ashleyjr/Switcher/README.md

# Switcher

Hackaday 1KB challenge

https://hackaday.io/project/18649-switcher

Switch mode power supply controlled by an 8051 microcontroller.
