ashleyjr/Switcher/Documentation/Switcher.pdf

# Switcher

# Ashley J. Robinson

# January 3, 2017

# 1 Introduction

# 2 Hardware

# 3 Software

# 3.1 Peripherals

# 3.1.1 Analogue to Digital Convertors (ADCs)

A single ADC is multiplexed to measure three voltages on the board.

# 3.1.2 Universal Asyncronhouse/Syncronhous Transceiver (UART)

The UART is configure to run at 115200 baud with no control flow with a ring buffer interface.

# Trasmission from the microcontroller happens through uartLoadOut which adds to the 8 byte buffer and is then unloaded from a timer. The input is not interrupt driven and is

handled in the main control loop using a 5 byte buffer that is enough to contain the longest command.

# 3.1.3 Programmable Counter Array (PCA)

# The Pulse Width Modulation (PWM) is controlled from the counter array. The output runs

at approximatly 96KHz with 8 bits to control the duty cycle. A high resolution for control would be favourable for this application but the frequency achieved in 16-bit mode is far too low for this application.

# 3.1.4 Timers

# Timer 0 is used as baud rate generagtion for the UART. Timer 2 is used to trigger an In-

terrupt Service Routine (ISR) which runs at 4KHz. The ISR control the UART transmission, sampling of the ADC, running the controller and finally setting the PWM.

# 3.2 Operation

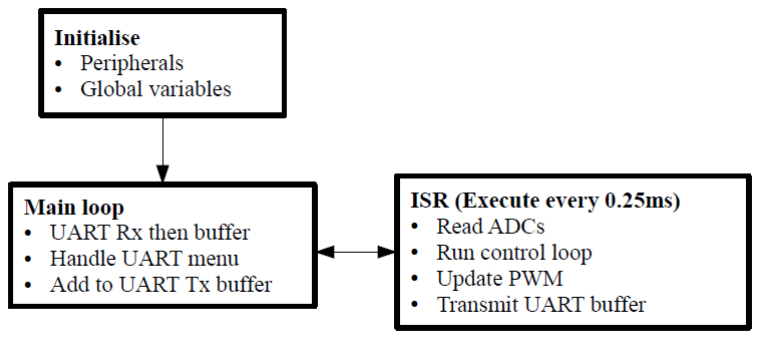
[picture p8: figure]

Figure 1: Software overview.

# 3.3 UART Menu

Command | Char | Send numbers | Return numbers | Notes
Enable | g | 0 | 0 | 0
Disable | s | 0 | 0 | 0
Read ADC1 | x | 0 | 4 | Result in mV
Read ADC2 | y | 0 | 4 | Result in mV
Read ADC3 | z | 0 | 4 | Result in mV
Read output current | j | 0 | 4 | Result in mA
Set output voltage | v | 4 | 0 | Send value in mV
Set otuput current | c | 4 | 0 | Send value in mA
Set controller P | p | 4 | 0 | Value is divide by 10
Set controller I | i | 4 | 0 | Value is divide by 10
Set input voltage up-per limit | u | 4 | 0 | Send value in mV
Set input voltage lower limit | l | 4 | 0 | Send value in mV

# Table 1: UART menu

# 3.4 Assembly analysis

The following sections of code are library function inserted by the compilier implict to facilite some more complex operations.

# 3.4.1 ADC scaling

Listing 1 is a line of code operating on a 32 bit signed integer and invokes listing 5 and 6. The purpose of this operation is to cast the voltage recorded by the ADC to a representation in mV. It is possible for the target voltage to be translated instead but this would still require

# the same piece of code. The 12 bit oputput but the ADC must be multiplied 5.926 as to

represent the voltage at the top of the potential divider. Fixed but multiplication followed by a shift operation removes the need for a floating point operation but yeilds the same result.

# Listing 1: LIMUL

return ((( U32 ) ADC0 )* SCALE_MUL ) >> 10;

# 3.4.2 ADC scaling

# 3.4.3 Division

Division and modulus operations are contained in 2 invoke the functions contained in 8.

# Listing 2: Division

scale /= 10;

num = out / scale ;

out %= scale ;

# 3.4.4 Switch

# This library function is generated to control large switch statements??

# 4 Testing

# The potential dividers constantly place the power supply under a load of 515Ω. To test both the UART interface anhd the switch mode functionaility a small python script is used to create GUI to plot values in real time. The input and output voltages recorded by the

mircocontroller are contained in Figure 2 and the actual values are contained in 3.


Figure 2: Sine wave output on GUI.


Figure 3: Sine wave output on scope.

# 5 Conclusion

# The complete assembly in listing 4 is generated from the code in listing 3. The C code is

contained within a single file and generates 950 lines of assembler with an additional 3 lines contained within the jump table and the jump on reset...

# - 0x0000 Jumps straight to 0x0800

# - 0x001B Jump table entry TIMER1 ISR(C:0BB6)

# - 0x002B Jump table entry TIMER2 ISR(C:094C)

# - 0x0800 First line of code generated from main.c

# - 0x0BB6 Final line of code generated from main.c

# The Keil c51 compilier limits machine code generation to 2KB (not a problem) however it also limits the use of memory less than 2KB by always jumping to address 2048 and

then continuing with the compiled assembler. Excluding the first 2048 is not completely fair because the jump on reset and the jump table would still exsist. The highest vector used in the jump table is at address 43 so assuming this is not optimised by the compilier the total code size comes to 993 bytes.

# 5.1 Further work

# - Improve output current

# - Replaced protection diodes with sutiable parts

# - Improve resolution of ADC to enable constant control

# 6 Appendix

# 6.1 Code listings

# Listing 3: main.c

// - - - - - - - - - - - - - - - - - - - - - - - - - - - - - - - - - - - - - - - - - - - - - - - - - - - - - - - - - - - - - - - - - - - - - - - - - - - - -// Project : Switcher
// File : | main . c
// Brief : | Single main file containing all code
// - - - - - - - - - - - - - - - - - - - - - - - - - - - - - - - - - - - - - - - - - - - - - - - - - - - - - - - - - - - - - - - - - - - - - - - - - - - - -

// - - - - - - - - - - - - - - - - - - - - - - - - - - - - - - - - - - - - - - - - - - - - - - - - - - - - - - - - - - - - - - - - - - - - - - - - - - - - -// Includes
// - - - - - - - - - - - - - - - - - - - - - - - - - - - - - - - - - - - - - - - - - - - - - - - - - - - - - - - - - - - - - - - - - - - - - - - - - - - - -

# include " SI_C8051F850_Register_Enums .h "

# include " SI_C8051F850_Defs .h"

// - - - - - - - - - - - - - - - - - - - - - - - - - - - - - - - - - - - - - - - - - - - - - - - - - - - - - - - - - - - - - - - - - - - - - - - - - - - - -// Defines
// - - - - - - - - - - - - - - - - - - - - - - - - - - - - - - - - - - - - - - - - - - - - - - - - - - - - - - - - - - - - - - - - - - - - - - - - - - - - -
# define SYSCLK | 24500000 | // SYSCLK frequency in Hz

# define BAUDRATE | 115200 | // Baud rate of UART in bps

# define P | 5

# define I | 2

# define UART_SIZE_IN | 5

# define UART_SIZE_OUT | 8

# define ADC1 | 0 x08

# define ADC2 | 0 x09

# define ADC3 | 0 x0A

# define SCALE_MUL | 6068 | // When combined with >> 10 will scale by 5.926 to compensate for potential divider

# define DEFAULT_OUT_MV | 5000

# define DEFAULT_HIGH_MV | 6000

# define DEFAULT_LOW_MV | 4000

SBIT ( TEST2 , SFR_P1 , 3); | // DS5 P1 .0 LED
SBIT ( TEST1 , SFR_P1 , 4); | // DS5 P1 .0 LED

// - - - - - - - - - - - - - - - - - - - - - - - - - - - - - - - - - - - - - - - - - - - - - - - - - - - - - - - - - - - - - - - - - - - - - - - - - - - - -// Prototypes
// - - - - - - - - - - - - - - - - - - - - - - - - - - - - - - - - - - - - - - - - - - - - - - - - - - - - - - - - - - - - - - - - - - - - - - - - - - - - -

U16 readAdc ( U8 sel );
void uartLoadOut ( U8 tx );
U16 uartNumbers ( U16 toSend , bool transmit );

// - - - - - - - - - - - - - - - - - - - - - - - - - - - - - - - - - - - - - - - - - - - - - - - - - - - - - - - - - - - - - - - - - - - - - - - - - - - - -// Global Variables
// - - - - - - - - - - - - - - - - - - - - - - - - - - - - - - - - - - - - - - - - - - - - - - - - - - - - - - - - - - - - - - - - - - - - - - - - - - - - -
volatile U8 | uart_in [ UART_SIZE_IN ];
volatile U8 | uart_out [ UART_SIZE_OUT ];
volatile U8 | head ;
volatile U8 | tail ;
volatile int | integral ;
volatile U8 | duty ;
volatile U16 | high_mV ;
volatile U16 | low_mV ;
volatile U16 | target_mV ;
volatile bool | enabled ;
volatile U16 | adc1 ;
volatile U16 | adc2 ;
volatile U16 | adc3 ;
volatile U16 | current ;

// - - - - - - - - - - - - - - - - - - - - - - - - - - - - - - - - - - - - - - - - - - - - - - - - - - - - - - - - - - - - - - - - - - - - - - - - - - - - -// Main Routine
// - - - - - - - - - - - - - - - - - - - - - - - - - - - - - - - - - - - - - - - - - - - - - - - - - - - - - - - - - - - - - - - - - - - - - - - - - - - - -

void main ( void ){
// Start of peripheral setup
U8 TCON_save ;
// Watchdog
WDTCN = 0 xDE ; | // First key
WDTCN = 0 xAD ; | // Second key - Watchdog now disabled
// Clock
CLKSEL =
CLKSEL_CLKSL__HFOSC | | | // Use 24.5 MHz interal clock
CLKSEL_CLKDIV__SYSCLK_DIV_1 ; | // Do not divide
// Port 0
P0MDOUT =
P0MDOUT_B0__PUSH_PULL | | | // PWM1 output
P0MDOUT_B1__PUSH_PULL | | | // PWM2 output
P0MDOUT_B2__OPEN_DRAIN | |
P0MDOUT_B3__OPEN_DRAIN | |
P0MDOUT_B4__PUSH_PULL | | | // UART TX
P0MDOUT_B5__OPEN_DRAIN | | | // UART RX
P0MDOUT_B6__OPEN_DRAIN | |

P0MDOUT_B7__OPEN_DRAIN ;
// Port 1
P1MDOUT =
P1MDOUT_B0__OPEN_DRAIN | |
P1MDOUT_B1__OPEN_DRAIN | |
P1MDOUT_B2__OPEN_DRAIN | |
P1MDOUT_B3__PUSH_PULL | | | // TEST2
P1MDOUT_B4__PUSH_PULL | | | // TEST1
P1MDOUT_B5__OPEN_DRAIN | |
P1MDOUT_B6__OPEN_DRAIN | |
P1MDOUT_B7__OPEN_DRAIN ;
P1MDIN =
P1MDIN_B0__ANALOG | | | // ADC1
P1MDIN_B1__ANALOG | | | // ADC2
P1MDIN_B2__ANALOG | | | // ADC3
P1MDIN_B3__DIGITAL | |
P1MDIN_B4__DIGITAL | |
P1MDIN_B5__DIGITAL | |
P1MDIN_B6__DIGITAL | |
P1MDIN_B7__DIGITAL ;
// Port crossbar
XBR0 =
XBR0_URT0E__ENABLED | | | // Route out UART
XBR0_SPI0E__DISABLED | |
XBR0_SMB0E__DISABLED | |
XBR0_CP0E__DISABLED | |
XBR0_CP0AE__DISABLED | |
XBR0_CP1E__DISABLED | |
XBR0_CP1AE__DISABLED | |
XBR0_SYSCKE__DISABLED ;
XBR1 =
XBR1_PCA0ME__CEX0_CEX1 | | | // Route out PCA0 and PCA1
XBR1_ECIE__DISABLED | |
XBR1_T0E__DISABLED | |
XBR1_T1E__DISABLED | |
XBR1_T2E__DISABLED ;
XBR2 =
XBR2_WEAKPUD__PULL_UPS_ENABLED | | | // Weak pull ups
XBR2_XBARE__ENABLED ; | | // Enable cross bar
// ADC
// ADC0MX = | | // Mux set in application
// | A D C 0 M X _ A D C 0 M X _ _ A D C 0 P 1 0 ;
ADC0CF =
(1 << ADC0CF_ADSC__SHIFT ) | |
ADC0CF_AD8BE__NORMAL | | | // ADC set to 10 bit
ADC0CF_ADGN__GAIN_1 | | | // ADC gain set to 1
ADC0CF_ADTM__TRACK_NORMAL ; | | // Immediate covert
ADC0CN0 &=
~ ADC0CN0_ADCM__FMASK ;
ADC0CN0 |=
ADC0CN0_ADEN__ENABLED | |
ADC0CN0_ADCM__ADBUSY ;
// Timer 0
TCON_save = TCON ;
TCON &=
TCON_TR0__BMASK | &
TCON_TR1__BMASK ;
TH1 = (150 << TH1_TH1__SHIFT );
TL1 = (150 << TL1_TL1__SHIFT );
TCON =
TCON_save ;
// Timer setup
CKCON =
CKCON_SCA__SYSCLK_DIV_12 | |
CKCON_T0M__PRESCALE | |
CKCON_T3MH__EXTERNAL_CLOCK | |
CKCON_T3ML__EXTERNAL_CLOCK | |
CKCON_T1M__SYSCLK ;
TMOD =
TMOD_T0M__MODE0 | |
TMOD_CT0__TIMER | |
TMOD_GATE0__DISABLED | |
TMOD_T1M__MODE2 | |
TMOD_CT1__TIMER | |
TMOD_GATE1__DISABLED ;
TCON |=
TCON_TR1__RUN ;
// UART
SCON0 |=
SCON0_REN__RECEIVE_ENABLED ;
// VREF
REF0CN =
REF0CN_REFSL__VDD_PIN | |
REF0CN_IREFLVL__1P65 | |
REF0CN_GNDSL__GND_PIN | |
REF0CN_TEMPE__TEMP_DISABLED ;
// RSTSRC
RSTSRC =
RSTSRC_C0RSEF__NOT_SET | |
RSTSRC_MCDRSF__SET | |
RSTSRC_PORSF__SET | |
RSTSRC_SWRSF__NOT_SET ;
// Interrupt
IE =
IE_EA__ENABLED | |
IE_EX0__DISABLED | |
IE_EX1__DISABLED | |
IE_ESPI0__DISABLED | |
IE_ET0__DISABLED | |

IE_ET1__ENABLED | | | // Timer 1 enabled
IE_ET2__ENABLED | | | // Timer 2 enabled
IE_ES0__ENABLED ;
IP =
IP_PX0__LOW | |
IP_PX1__LOW | |
IP_PSPI0__LOW | |
IP_PT0__LOW | |
IP_PT1__LOW | |
IP_PT2__HIGH | | | // Timer 2 highest priority
IP_PS0__LOW ;
// PCA
PCA0CN_CR =
PCA0CN_CR__STOP ;
PCA0CPM0 =
PCA0CPM0_CAPN__DISABLED | |
PCA0CPM0_ECCF__ENABLED | |
PCA0CPM0_MAT__ENABLED | |
PCA0CPM0_CAPP__DISABLED | |
PCA0CPM0_ECOM__ENABLED | |
PCA0CPM0_PWM__ENABLED | |
PCA0CPM0_TOG__DISABLED ;
PCA0CPM1 =
PCA0CPM1_CAPN__DISABLED | |
PCA0CPM1_ECCF__ENABLED | |
PCA0CPM1_MAT__ENABLED | |
PCA0CPM1_CAPP__DISABLED | |
PCA0CPM1_ECOM__ENABLED | |
PCA0CPM1_PWM__ENABLED | |
PCA0CPM1_TOG__DISABLED ;
PCA0MD =
PCA0MD_CIDL__NORMAL | |
PCA0MD_ECF__OVF_INT_DISABLED | |
PCA0MD_CPS__SYSCLK ;
PCA0CN |=
PCA0CN_CR__RUN ;
// Timer 2
TMR2CN |= TMR2CN_TR2__RUN ; // End of peripheral setup
enabled | = false ;
integral | = 0;
target_mV | = DEFAULT_OUT_MV ;
high_mV | = DEFAULT_HIGH_MV ;
low_mV | = DEFAULT_LOW_MV ;
SCON0_TI | = 1;
SCON0_RI | = 0;

while (1){
if ( SCON0_RI ){
SCON0_RI = 0;
uart_in [4] = uart_in [3]; | // Small buffer , less code not to use loop
uart_in [3] = uart_in [2];
uart_in [2] = uart_in [1];
uart_in [1] = uart_in [0];
uart_in [0] = SBUF0 ;

uartLoadOut ( uart_in [0]);

switch ( uart_in [0]){
case ’a ’: uartNumbers ( target_mV , true ); break ;
case ’c ’: uartNumbers ( current , true ); break ;
case ’d ’: uartNumbers ( duty , true ); break ;
case ’g ’: | enabled | = true ;
integral | = 0;
break ;
case ’s ’: | enabled | = false ;
break ;
case ’m ’: uartNumbers ( high_mV , true ); break ;
case ’n ’: uartNumbers ( low_mV , true ); break ;
case ’x ’: uartNumbers ( adc1 , true ); break ;
case ’y ’: uartNumbers ( adc2 , true ); break ;
case ’z ’: uartNumbers ( adc3 , true ); break ;
default : | switch ( uart_in [4]){
case ’h ’: | high_mV | = uartNumbers ( high_mV , false );
break ;
case ’l ’: | low_mV | = uartNumbers ( low_mV , false );
break ;
case ’v ’: | target_mV | = uartNumbers ( target_mV , false );
integral | = 0;
break ;
}
break ;
}
}
}
}

// - - - - - - - - - - - - - - - - - - - - - - - - - - - - - - - - - - - - - - - - - - - - - - - - - - - - - - - - - - - - - - - - - - - - - - - - - - - - -// Routines

// - - - - - - - - - - - - - - - - - - - - - - - - - - - - - - - - - - - - - - - - - - - - - - - - - - - - - - - - - - - - - - - - - - - - - - - - - - - - -

void uartLoadOut ( U8 tx ){ | // Handle buffering out Tx UART
uart_out [ head ] = tx ; | // Buffer outgoing
head ++;
head %= UART_SIZE_OUT ; | // Wrap around
}
U16 uartNumbers ( U16 toSend , bool transmit ){ | // Tx / Rx up to 4 length numbers over UART
U16 out = toSend ;
U16 num = 0;
U16 scale = 10000;
U8 test ;
U8 i = 4;
bool bad = false ;
while (i ){ | // On zero done
scale /= 10; | // Shift
i - -; | // Move through UART array
test = uart_in [i] - 48; | // ascii to num
if ( test > 10){ | // check is 0 to 9 , unsigned
bad = true ;
}
num += test * scale ; | // shift in to position
if ( transmit ){ | // Put if statement at back of loop to save on jumps
num = out / scale ; | // 10 powers
uartLoadOut ( num + 48); | // Number to ascii
out %= scale ; | // Remainder for next time
}
}
uartLoadOut ( ’\ n ’);
uartLoadOut ( ’\ r ’);
if ( bad ){
num = DEFAULT_OUT_MV ; | // Not all valid numbers so set output as default
}
return num ;
}
U16 readAdc ( U8 sel ){ | // Read the available ADCs
U8 i;
ADC0MX = sel ;
for (i =0; i <2; i ++){
ADC0CN0 |= ADC0CN0_ADBUSY__SET ;
while ( ADC0CN0 & ADC0CN0_ADBUSY__SET ); | // Wait for sample to complete
}
return ((( U32 ) ADC0 )* SCALE_MUL ) >> 10; | // Scale to mV
}

// - - - - - - - - - - - - - - - - - - - - - - - - - - - - - - - - - - - - - - - - - - - - - - - - - - - - - - - - - - - - - - - - - - - - - - - - - - - - -// Interrupt Routines
// - - - - - - - - - - - - - - - - - - - - - - - - - - - - - - - - - - - - - - - - - - - - - - - - - - - - - - - - - - - - - - - - - - - - - - - - - - - - -
INTERRUPT ( TIMER1_ISR , TIMER1_IRQn ){} | // Needed for UART timing
INTERRUPT ( TIMER2_ISR , TIMER2_IRQn ){ | // One timer handling UART Tx and PID
int out ;
int error ;
TEST1 = 1;

adc1 = readAdc ( ADC1 );
adc2 = readAdc ( ADC2 );
adc3 = readAdc ( ADC3 );
current = ( adc2 - adc3 )*10;
if (( adc1 < low_mV ) || ( adc1 > high_mV )){ | // Watch input voltage
enabled = false ;
}
error = ( int ) target_mV - ( int ) adc3 ; | // PID controller
integral += error ;
out = (( error *P) + ( integral *I )) >> 10; | // Divide by 1024
if (( out < 0) || (! enabled )){
out = 0;
}
duty = out ;
PCA0CPH0 = PCA0CPH1 = 0 xFF - out ;

if ( head != tail ){
SBUF0 = uart_out [ tail ]; | // Timer tuned so no need to check
tail ++; | // Transmit UART
tail %= UART_SIZE_OUT ; | // Wrap around
}
TMR2H = 255; | // Runs at 4 KHz
TMR2CN_TF2H = 0; | // Enable interrupt again
TEST1 = 0; | // Timing debug
}

// - - - - - - - - - - - - - - - - - - - - - - - - - - - - - - - - - - - - - - - - - - - - - - - - - - - - - - - - - - - - - - - - - - - - - - - - - - - - -// END
// - - - - - - - - - - - - - - - - - - - - - - - - - - - - - - - - - - - - - - - - - - - - - - - - - - - - - - - - - - - - - - - - - - - - - - - - - - - - -

# Listing 4: Swicther.asm

C :0 x0000 | 020 BAA | LJMP | C :0 BAA
C :0 x0003 | 00 | NOP
C :0 x0004 | 00 | NOP
C :0 x0005 | 00 | NOP
C :0 x0006 | 00 | NOP
C :0 x0007 | 00 | NOP
C :0 x0008 | 00 | NOP
C :0 x0009 | 00 | NOP
C :0 x000A | 00 | NOP
C :0 x000B | 00 | NOP
C :0 x000C | 00 | NOP
C :0 x000D | 00 | NOP
C :0 x000E | 00 | NOP
C :0 x000F | 00 | NOP
C :0 x0010 | 00 | NOP
C :0 x0011 | 00 | NOP
C :0 x0012 | 00 | NOP
C :0 x0013 | 00 | NOP
C :0 x0014 | 00 | NOP
C :0 x0015 | 00 | NOP
C :0 x0016 | 00 | NOP
C :0 x0017 | 00 | NOP
C :0 x0018 | 00 | NOP
C :0 x0019 | 00 | NOP
C :0 x001A | 00 | NOP
C :0 x001B | 020 BB6 | LJMP | TIMER1_ISR (C :0 BB6 )
C :0 x001E | 00 | NOP
C :0 x001F | 00 | NOP
C :0 x0020 | 00 | NOP
C :0 x0021 | 00 | NOP
C :0 x0022 | 00 | NOP
C :0 x0023 | 00 | NOP
C :0 x0024 | 00 | NOP
C :0 x0025 | 00 | NOP
C :0 x0026 | 00 | NOP
C :0 x0027 | 00 | NOP
C :0 x0028 | 00 | NOP
C :0 x0029 | 00 | NOP
C :0 x002A | 00 | NOP
C :0 x002B | 02094 C | LJMP | TIMER2_ISR (C :094 C )
C :0 x002E | 00 | NOP
C :0 x002F | 00 | NOP
C :0 x0030 | 00 | NOP
C :0 x0031 | 00 | NOP
C :0 x0032 | 00 | NOP
C :0 x0033 | 00 | NOP
C :0 x0034 | 00 | NOP
C :0 x0035 | 00 | NOP
C :0 x0036 | 00 | NOP
C :0 x0037 | 00 | NOP
C :0 x0038 | 00 | NOP
C :0 x0039 | 00 | NOP
C :0 x003A | 00 | NOP
C :0 x003B | 00 | NOP
C :0 x003C | 00 | NOP
C :0 x003D | 00 | NOP
C :0 x003E | 00 | NOP
C :0 x003F | 00 | NOP
C :0 x0040 | 00 | NOP
C :0 x0041 | 00 | NOP
C :0 x0042 | 00 | NOP
C :0 x0043 | 00 | NOP
C :0 x0044 | 00 | NOP
C :0 x0045 | 00 | NOP
C :0 x0046 | 00 | NOP
C :0 x0047 | 00 | NOP
C :0 x0048 | 00 | NOP
C :0 x0049 | 00 | NOP
C :0 x004A | 00 | NOP
C :0 x004B | 00 | NOP
C :0 x004C | 00 | NOP
C :0 x004D | 00 | NOP
C :0 x004E | 00 | NOP
C :0 x004F | 00 | NOP
C :0 x0050 | 00 | NOP
C :0 x0051 | 00 | NOP
C :0 x0052 | 00 | NOP
C :0 x0053 | 00 | NOP
C :0 x0054 | 00 | NOP
C :0 x0055 | 00 | NOP
C :0 x0056 | 00 | NOP
C :0 x0057 | 00 | NOP
C :0 x0058 | 00 | NOP
C :0 x0059 | 00 | NOP
C :0 x005A | 00 | NOP
C :0 x005B | 00 | NOP
C :0 x005C | 00 | NOP
C :0 x005D | 00 | NOP
C :0 x005E | 00 | NOP
C :0 x005F | 00 | NOP
C :0 x0060 | 00 | NOP
C :0 x0061 | 00 | NOP
C :0 x0062 | 00 | NOP
C :0 x0063 | 00 | NOP
C :0 x0064 | 00 | NOP
C :0 x0065 | 00 | NOP
C :0 x0066 | 00 | NOP
C :0 x0067 | 00 | NOP

C :0 x0068 | 00 | NOP
C :0 x0069 | 00 | NOP
C :0 x006A | 00 | NOP
C :0 x006B | 00 | NOP
C :0 x006C | 00 | NOP
C :0 x006D | 00 | NOP
C :0 x006E | 00 | NOP
C :0 x006F | 00 | NOP
C :0 x0070 | 00 | NOP
C :0 x0071 | 00 | NOP
C :0 x0072 | 00 | NOP
C :0 x0073 | 00 | NOP
C :0 x0074 | 00 | NOP
C :0 x0075 | 00 | NOP
C :0 x0076 | 00 | NOP
C :0 x0077 | 00 | NOP
C :0 x0078 | 00 | NOP
C :0 x0079 | 00 | NOP
C :0 x007A | 00 | NOP
C :0 x007B | 00 | NOP
C :0 x007C | 00 | NOP
C :0 x007D | 00 | NOP
C :0 x007E | 00 | NOP
C :0 x007F | 00 | NOP
C :0 x0080 | 00 | NOP
C :0 x0081 | 00 | NOP
C :0 x0082 | 00 | NOP
C :0 x0083 | 00 | NOP
C :0 x0084 | 00 | NOP
C :0 x0085 | 00 | NOP
C :0 x0086 | 00 | NOP
C :0 x0087 | 00 | NOP
C :0 x0088 | 00 | NOP
C :0 x0089 | 00 | NOP
C :0 x008A | 00 | NOP
C :0 x008B | 00 | NOP
C :0 x008C | 00 | NOP
C :0 x008D | 00 | NOP
C :0 x008E | 00 | NOP
C :0 x008F | 00 | NOP
C :0 x0090 | 00 | NOP
C :0 x0091 | 00 | NOP
C :0 x0092 | 00 | NOP
C :0 x0093 | 00 | NOP
C :0 x0094 | 00 | NOP
C :0 x0095 | 00 | NOP
C :0 x0096 | 00 | NOP
C :0 x0097 | 00 | NOP
C :0 x0098 | 00 | NOP
C :0 x0099 | 00 | NOP
C :0 x009A | 00 | NOP
C :0 x009B | 00 | NOP
C :0 x009C | 00 | NOP
C :0 x009D | 00 | NOP
C :0 x009E | 00 | NOP
C :0 x009F | 00 | NOP
C :0 x00A0 | 00 | NOP
C :0 x00A1 | 00 | NOP
C :0 x00A2 | 00 | NOP
C :0 x00A3 | 00 | NOP
C :0 x00A4 | 00 | NOP
C :0 x00A5 | 00 | NOP
C :0 x00A6 | 00 | NOP
C :0 x00A7 | 00 | NOP
C :0 x00A8 | 00 | NOP
C :0 x00A9 | 00 | NOP
C :0 x00AA | 00 | NOP
C :0 x00AB | 00 | NOP
C :0 x00AC | 00 | NOP
C :0 x00AD | 00 | NOP
C :0 x00AE | 00 | NOP
C :0 x00AF | 00 | NOP
C :0 x00B0 | 00 | NOP
C :0 x00B1 | 00 | NOP
C :0 x00B2 | 00 | NOP
C :0 x00B3 | 00 | NOP
C :0 x00B4 | 00 | NOP
C :0 x00B5 | 00 | NOP
C :0 x00B6 | 00 | NOP
C :0 x00B7 | 00 | NOP
C :0 x00B8 | 00 | NOP
C :0 x00B9 | 00 | NOP
C :0 x00BA | 00 | NOP
C :0 x00BB | 00 | NOP
C :0 x00BC | 00 | NOP
C :0 x00BD | 00 | NOP
C :0 x00BE | 00 | NOP
C :0 x00BF | 00 | NOP
C :0 x00C0 | 00 | NOP
C :0 x00C1 | 00 | NOP
C :0 x00C2 | 00 | NOP
C :0 x00C3 | 00 | NOP
C :0 x00C4 | 00 | NOP
C :0 x00C5 | 00 | NOP
C :0 x00C6 | 00 | NOP
C :0 x00C7 | 00 | NOP
C :0 x00C8 | 00 | NOP
C :0 x00C9 | 00 | NOP
C :0 x00CA | 00 | NOP

C :0 x00CB | 00 | NOP
C :0 x00CC | 00 | NOP
C :0 x00CD | 00 | NOP
C :0 x00CE | 00 | NOP
C :0 x00CF | 00 | NOP
C :0 x00D0 | 00 | NOP
C :0 x00D1 | 00 | NOP
C :0 x00D2 | 00 | NOP
C :0 x00D3 | 00 | NOP
C :0 x00D4 | 00 | NOP
C :0 x00D5 | 00 | NOP
C :0 x00D6 | 00 | NOP
C :0 x00D7 | 00 | NOP
C :0 x00D8 | 00 | NOP
C :0 x00D9 | 00 | NOP
C :0 x00DA | 00 | NOP
C :0 x00DB | 00 | NOP
C :0 x00DC | 00 | NOP
C :0 x00DD | 00 | NOP
C :0 x00DE | 00 | NOP
C :0 x00DF | 00 | NOP
C :0 x00E0 | 00 | NOP
C :0 x00E1 | 00 | NOP
C :0 x00E2 | 00 | NOP
C :0 x00E3 | 00 | NOP
C :0 x00E4 | 00 | NOP
C :0 x00E5 | 00 | NOP
C :0 x00E6 | 00 | NOP
C :0 x00E7 | 00 | NOP
C :0 x00E8 | 00 | NOP
C :0 x00E9 | 00 | NOP
C :0 x00EA | 00 | NOP
C :0 x00EB | 00 | NOP
C :0 x00EC | 00 | NOP
C :0 x00ED | 00 | NOP
C :0 x00EE | 00 | NOP
C :0 x00EF | 00 | NOP
C :0 x00F0 | 00 | NOP
C :0 x00F1 | 00 | NOP
C :0 x00F2 | 00 | NOP
C :0 x00F3 | 00 | NOP
C :0 x00F4 | 00 | NOP
C :0 x00F5 | 00 | NOP
C :0 x00F6 | 00 | NOP
C :0 x00F7 | 00 | NOP
C :0 x00F8 | 00 | NOP
C :0 x00F9 | 00 | NOP
C :0 x00FA | 00 | NOP
C :0 x00FB | 00 | NOP
C :0 x00FC | 00 | NOP
C :0 x00FD | 00 | NOP
C :0 x00FE | 00 | NOP
C :0 x00FF | 00 | NOP
C :0 x0100 | 00 | NOP
C :0 x0101 | 00 | NOP
C :0 x0102 | 00 | NOP
C :0 x0103 | 00 | NOP
C :0 x0104 | 00 | NOP
C :0 x0105 | 00 | NOP
C :0 x0106 | 00 | NOP
C :0 x0107 | 00 | NOP
C :0 x0108 | 00 | NOP
C :0 x0109 | 00 | NOP
C :0 x010A | 00 | NOP
C :0 x010B | 00 | NOP
C :0 x010C | 00 | NOP
C :0 x010D | 00 | NOP
C :0 x010E | 00 | NOP
C :0 x010F | 00 | NOP
C :0 x0110 | 00 | NOP
C :0 x0111 | 00 | NOP
C :0 x0112 | 00 | NOP
C :0 x0113 | 00 | NOP
C :0 x0114 | 00 | NOP
C :0 x0115 | 00 | NOP
C :0 x0116 | 00 | NOP
C :0 x0117 | 00 | NOP
C :0 x0118 | 00 | NOP
C :0 x0119 | 00 | NOP
C :0 x011A | 00 | NOP
C :0 x011B | 00 | NOP
C :0 x011C | 00 | NOP
C :0 x011D | 00 | NOP
C :0 x011E | 00 | NOP
C :0 x011F | 00 | NOP
C :0 x0120 | 00 | NOP
C :0 x0121 | 00 | NOP
C :0 x0122 | 00 | NOP
C :0 x0123 | 00 | NOP
C :0 x0124 | 00 | NOP
C :0 x0125 | 00 | NOP
C :0 x0126 | 00 | NOP
C :0 x0127 | 00 | NOP
C :0 x0128 | 00 | NOP
C :0 x0129 | 00 | NOP
C :0 x012A | 00 | NOP
C :0 x012B | 00 | NOP
C :0 x012C | 00 | NOP
C :0 x012D | 00 | NOP

C :0 x012E | 00 | NOP
C :0 x012F | 00 | NOP
C :0 x0130 | 00 | NOP
C :0 x0131 | 00 | NOP
C :0 x0132 | 00 | NOP
C :0 x0133 | 00 | NOP
C :0 x0134 | 00 | NOP
C :0 x0135 | 00 | NOP
C :0 x0136 | 00 | NOP
C :0 x0137 | 00 | NOP
C :0 x0138 | 00 | NOP
C :0 x0139 | 00 | NOP
C :0 x013A | 00 | NOP
C :0 x013B | 00 | NOP
C :0 x013C | 00 | NOP
C :0 x013D | 00 | NOP
C :0 x013E | 00 | NOP
C :0 x013F | 00 | NOP
C :0 x0140 | 00 | NOP
C :0 x0141 | 00 | NOP
C :0 x0142 | 00 | NOP
C :0 x0143 | 00 | NOP
C :0 x0144 | 00 | NOP
C :0 x0145 | 00 | NOP
C :0 x0146 | 00 | NOP
C :0 x0147 | 00 | NOP
C :0 x0148 | 00 | NOP
C :0 x0149 | 00 | NOP
C :0 x014A | 00 | NOP
C :0 x014B | 00 | NOP
C :0 x014C | 00 | NOP
C :0 x014D | 00 | NOP
C :0 x014E | 00 | NOP
C :0 x014F | 00 | NOP
C :0 x0150 | 00 | NOP
C :0 x0151 | 00 | NOP
C :0 x0152 | 00 | NOP
C :0 x0153 | 00 | NOP
C :0 x0154 | 00 | NOP
C :0 x0155 | 00 | NOP
C :0 x0156 | 00 | NOP
C :0 x0157 | 00 | NOP
C :0 x0158 | 00 | NOP
C :0 x0159 | 00 | NOP
C :0 x015A | 00 | NOP
C :0 x015B | 00 | NOP
C :0 x015C | 00 | NOP
C :0 x015D | 00 | NOP
C :0 x015E | 00 | NOP
C :0 x015F | 00 | NOP
C :0 x0160 | 00 | NOP
C :0 x0161 | 00 | NOP
C :0 x0162 | 00 | NOP
C :0 x0163 | 00 | NOP
C :0 x0164 | 00 | NOP
C :0 x0165 | 00 | NOP
C :0 x0166 | 00 | NOP
C :0 x0167 | 00 | NOP
C :0 x0168 | 00 | NOP
C :0 x0169 | 00 | NOP
C :0 x016A | 00 | NOP
C :0 x016B | 00 | NOP
C :0 x016C | 00 | NOP
C :0 x016D | 00 | NOP
C :0 x016E | 00 | NOP
C :0 x016F | 00 | NOP
C :0 x0170 | 00 | NOP
C :0 x0171 | 00 | NOP
C :0 x0172 | 00 | NOP
C :0 x0173 | 00 | NOP
C :0 x0174 | 00 | NOP
C :0 x0175 | 00 | NOP
C :0 x0176 | 00 | NOP
C :0 x0177 | 00 | NOP
C :0 x0178 | 00 | NOP
C :0 x0179 | 00 | NOP
C :0 x017A | 00 | NOP
C :0 x017B | 00 | NOP
C :0 x017C | 00 | NOP
C :0 x017D | 00 | NOP
C :0 x017E | 00 | NOP
C :0 x017F | 00 | NOP
C :0 x0180 | 00 | NOP
C :0 x0181 | 00 | NOP
C :0 x0182 | 00 | NOP
C :0 x0183 | 00 | NOP
C :0 x0184 | 00 | NOP
C :0 x0185 | 00 | NOP
C :0 x0186 | 00 | NOP
C :0 x0187 | 00 | NOP
C :0 x0188 | 00 | NOP
C :0 x0189 | 00 | NOP
C :0 x018A | 00 | NOP
C :0 x018B | 00 | NOP
C :0 x018C | 00 | NOP
C :0 x018D | 00 | NOP
C :0 x018E | 00 | NOP
C :0 x018F | 00 | NOP
C :0 x0190 | 00 | NOP

C :0 x0191 | 00 | NOP
C :0 x0192 | 00 | NOP
C :0 x0193 | 00 | NOP
C :0 x0194 | 00 | NOP
C :0 x0195 | 00 | NOP
C :0 x0196 | 00 | NOP
C :0 x0197 | 00 | NOP
C :0 x0198 | 00 | NOP
C :0 x0199 | 00 | NOP
C :0 x019A | 00 | NOP
C :0 x019B | 00 | NOP
C :0 x019C | 00 | NOP
C :0 x019D | 00 | NOP
C :0 x019E | 00 | NOP
C :0 x019F | 00 | NOP
C :0 x01A0 | 00 | NOP
C :0 x01A1 | 00 | NOP
C :0 x01A2 | 00 | NOP
C :0 x01A3 | 00 | NOP
C :0 x01A4 | 00 | NOP
C :0 x01A5 | 00 | NOP
C :0 x01A6 | 00 | NOP
C :0 x01A7 | 00 | NOP
C :0 x01A8 | 00 | NOP
C :0 x01A9 | 00 | NOP
C :0 x01AA | 00 | NOP
C :0 x01AB | 00 | NOP
C :0 x01AC | 00 | NOP
C :0 x01AD | 00 | NOP
C :0 x01AE | 00 | NOP
C :0 x01AF | 00 | NOP
C :0 x01B0 | 00 | NOP
C :0 x01B1 | 00 | NOP
C :0 x01B2 | 00 | NOP
C :0 x01B3 | 00 | NOP
C :0 x01B4 | 00 | NOP
C :0 x01B5 | 00 | NOP
C :0 x01B6 | 00 | NOP
C :0 x01B7 | 00 | NOP
C :0 x01B8 | 00 | NOP
C :0 x01B9 | 00 | NOP
C :0 x01BA | 00 | NOP
C :0 x01BB | 00 | NOP
C :0 x01BC | 00 | NOP
C :0 x01BD | 00 | NOP
C :0 x01BE | 00 | NOP
C :0 x01BF | 00 | NOP
C :0 x01C0 | 00 | NOP
C :0 x01C1 | 00 | NOP
C :0 x01C2 | 00 | NOP
C :0 x01C3 | 00 | NOP
C :0 x01C4 | 00 | NOP
C :0 x01C5 | 00 | NOP
C :0 x01C6 | 00 | NOP
C :0 x01C7 | 00 | NOP
C :0 x01C8 | 00 | NOP
C :0 x01C9 | 00 | NOP
C :0 x01CA | 00 | NOP
C :0 x01CB | 00 | NOP
C :0 x01CC | 00 | NOP
C :0 x01CD | 00 | NOP
C :0 x01CE | 00 | NOP
C :0 x01CF | 00 | NOP
C :0 x01D0 | 00 | NOP
C :0 x01D1 | 00 | NOP
C :0 x01D2 | 00 | NOP
C :0 x01D3 | 00 | NOP
C :0 x01D4 | 00 | NOP
C :0 x01D5 | 00 | NOP
C :0 x01D6 | 00 | NOP
C :0 x01D7 | 00 | NOP
C :0 x01D8 | 00 | NOP
C :0 x01D9 | 00 | NOP
C :0 x01DA | 00 | NOP
C :0 x01DB | 00 | NOP
C :0 x01DC | 00 | NOP
C :0 x01DD | 00 | NOP
C :0 x01DE | 00 | NOP
C :0 x01DF | 00 | NOP
C :0 x01E0 | 00 | NOP
C :0 x01E1 | 00 | NOP
C :0 x01E2 | 00 | NOP
C :0 x01E3 | 00 | NOP
C :0 x01E4 | 00 | NOP
C :0 x01E5 | 00 | NOP
C :0 x01E6 | 00 | NOP
C :0 x01E7 | 00 | NOP
C :0 x01E8 | 00 | NOP
C :0 x01E9 | 00 | NOP
C :0 x01EA | 00 | NOP
C :0 x01EB | 00 | NOP
C :0 x01EC | 00 | NOP
C :0 x01ED | 00 | NOP
C :0 x01EE | 00 | NOP
C :0 x01EF | 00 | NOP
C :0 x01F0 | 00 | NOP
C :0 x01F1 | 00 | NOP
C :0 x01F2 | 00 | NOP
C :0 x01F3 | 00 | NOP

C :0 x01F4 | 00 | NOP
C :0 x01F5 | 00 | NOP
C :0 x01F6 | 00 | NOP
C :0 x01F7 | 00 | NOP
C :0 x01F8 | 00 | NOP
C :0 x01F9 | 00 | NOP
C :0 x01FA | 00 | NOP
C :0 x01FB | 00 | NOP
C :0 x01FC | 00 | NOP
C :0 x01FD | 00 | NOP
C :0 x01FE | 00 | NOP
C :0 x01FF | 00 | NOP
C :0 x0200 | 00 | NOP
C :0 x0201 | 00 | NOP
C :0 x0202 | 00 | NOP
C :0 x0203 | 00 | NOP
C :0 x0204 | 00 | NOP
C :0 x0205 | 00 | NOP
C :0 x0206 | 00 | NOP
C :0 x0207 | 00 | NOP
C :0 x0208 | 00 | NOP
C :0 x0209 | 00 | NOP
C :0 x020A | 00 | NOP
C :0 x020B | 00 | NOP
C :0 x020C | 00 | NOP
C :0 x020D | 00 | NOP
C :0 x020E | 00 | NOP
C :0 x020F | 00 | NOP
C :0 x0210 | 00 | NOP
C :0 x0211 | 00 | NOP
C :0 x0212 | 00 | NOP
C :0 x0213 | 00 | NOP
C :0 x0214 | 00 | NOP
C :0 x0215 | 00 | NOP
C :0 x0216 | 00 | NOP
C :0 x0217 | 00 | NOP
C :0 x0218 | 00 | NOP
C :0 x0219 | 00 | NOP
C :0 x021A | 00 | NOP
C :0 x021B | 00 | NOP
C :0 x021C | 00 | NOP
C :0 x021D | 00 | NOP
C :0 x021E | 00 | NOP
C :0 x021F | 00 | NOP
C :0 x0220 | 00 | NOP
C :0 x0221 | 00 | NOP
C :0 x0222 | 00 | NOP
C :0 x0223 | 00 | NOP
C :0 x0224 | 00 | NOP
C :0 x0225 | 00 | NOP
C :0 x0226 | 00 | NOP
C :0 x0227 | 00 | NOP
C :0 x0228 | 00 | NOP
C :0 x0229 | 00 | NOP
C :0 x022A | 00 | NOP
C :0 x022B | 00 | NOP
C :0 x022C | 00 | NOP
C :0 x022D | 00 | NOP
C :0 x022E | 00 | NOP
C :0 x022F | 00 | NOP
C :0 x0230 | 00 | NOP
C :0 x0231 | 00 | NOP
C :0 x0232 | 00 | NOP
C :0 x0233 | 00 | NOP
C :0 x0234 | 00 | NOP
C :0 x0235 | 00 | NOP
C :0 x0236 | 00 | NOP
C :0 x0237 | 00 | NOP
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
C :0 x02AD | 00 | NOP
C :0 x02AE | 00 | NOP
C :0 x02AF | 00 | NOP
C :0 x02B0 | 00 | NOP
C :0 x02B1 | 00 | NOP
C :0 x02B2 | 00 | NOP
C :0 x02B3 | 00 | NOP
C :0 x02B4 | 00 | NOP
C :0 x02B5 | 00 | NOP
C :0 x02B6 | 00 | NOP
C :0 x02B7 | 00 | NOP
C :0 x02B8 | 00 | NOP
C :0 x02B9 | 00 | NOP

C :0 x02BA | 00 | NOP
C :0 x02BB | 00 | NOP
C :0 x02BC | 00 | NOP
C :0 x02BD | 00 | NOP
C :0 x02BE | 00 | NOP
C :0 x02BF | 00 | NOP
C :0 x02C0 | 00 | NOP
C :0 x02C1 | 00 | NOP
C :0 x02C2 | 00 | NOP
C :0 x02C3 | 00 | NOP
C :0 x02C4 | 00 | NOP
C :0 x02C5 | 00 | NOP
C :0 x02C6 | 00 | NOP
C :0 x02C7 | 00 | NOP
C :0 x02C8 | 00 | NOP
C :0 x02C9 | 00 | NOP
C :0 x02CA | 00 | NOP
C :0 x02CB | 00 | NOP
C :0 x02CC | 00 | NOP
C :0 x02CD | 00 | NOP
C :0 x02CE | 00 | NOP
C :0 x02CF | 00 | NOP
C :0 x02D0 | 00 | NOP
C :0 x02D1 | 00 | NOP
C :0 x02D2 | 00 | NOP
C :0 x02D3 | 00 | NOP
C :0 x02D4 | 00 | NOP
C :0 x02D5 | 00 | NOP
C :0 x02D6 | 00 | NOP
C :0 x02D7 | 00 | NOP
C :0 x02D8 | 00 | NOP
C :0 x02D9 | 00 | NOP
C :0 x02DA | 00 | NOP
C :0 x02DB | 00 | NOP
C :0 x02DC | 00 | NOP
C :0 x02DD | 00 | NOP
C :0 x02DE | 00 | NOP
C :0 x02DF | 00 | NOP
C :0 x02E0 | 00 | NOP
C :0 x02E1 | 00 | NOP
C :0 x02E2 | 00 | NOP
C :0 x02E3 | 00 | NOP
C :0 x02E4 | 00 | NOP
C :0 x02E5 | 00 | NOP
C :0 x02E6 | 00 | NOP
C :0 x02E7 | 00 | NOP
C :0 x02E8 | 00 | NOP
C :0 x02E9 | 00 | NOP
C :0 x02EA | 00 | NOP
C :0 x02EB | 00 | NOP
C :0 x02EC | 00 | NOP
C :0 x02ED | 00 | NOP
C :0 x02EE | 00 | NOP
C :0 x02EF | 00 | NOP
C :0 x02F0 | 00 | NOP
C :0 x02F1 | 00 | NOP
C :0 x02F2 | 00 | NOP
C :0 x02F3 | 00 | NOP
C :0 x02F4 | 00 | NOP
C :0 x02F5 | 00 | NOP
C :0 x02F6 | 00 | NOP
C :0 x02F7 | 00 | NOP
C :0 x02F8 | 00 | NOP
C :0 x02F9 | 00 | NOP
C :0 x02FA | 00 | NOP
C :0 x02FB | 00 | NOP
C :0 x02FC | 00 | NOP
C :0 x02FD | 00 | NOP
C :0 x02FE | 00 | NOP
C :0 x02FF | 00 | NOP
C :0 x0300 | 00 | NOP
C :0 x0301 | 00 | NOP
C :0 x0302 | 00 | NOP
C :0 x0303 | 00 | NOP
C :0 x0304 | 00 | NOP
C :0 x0305 | 00 | NOP
C :0 x0306 | 00 | NOP
C :0 x0307 | 00 | NOP
C :0 x0308 | 00 | NOP
C :0 x0309 | 00 | NOP
C :0 x030A | 00 | NOP
C :0 x030B | 00 | NOP
C :0 x030C | 00 | NOP
C :0 x030D | 00 | NOP
C :0 x030E | 00 | NOP
C :0 x030F | 00 | NOP
C :0 x0310 | 00 | NOP
C :0 x0311 | 00 | NOP
C :0 x0312 | 00 | NOP
C :0 x0313 | 00 | NOP
C :0 x0314 | 00 | NOP
C :0 x0315 | 00 | NOP
C :0 x0316 | 00 | NOP
C :0 x0317 | 00 | NOP
C :0 x0318 | 00 | NOP
C :0 x0319 | 00 | NOP
C :0 x031A | 00 | NOP
C :0 x031B | 00 | NOP
C :0 x031C | 00 | NOP

C :0 x031D | 00 | NOP
C :0 x031E | 00 | NOP
C :0 x031F | 00 | NOP
C :0 x0320 | 00 | NOP
C :0 x0321 | 00 | NOP
C :0 x0322 | 00 | NOP
C :0 x0323 | 00 | NOP
C :0 x0324 | 00 | NOP
C :0 x0325 | 00 | NOP
C :0 x0326 | 00 | NOP
C :0 x0327 | 00 | NOP
C :0 x0328 | 00 | NOP
C :0 x0329 | 00 | NOP
C :0 x032A | 00 | NOP
C :0 x032B | 00 | NOP
C :0 x032C | 00 | NOP
C :0 x032D | 00 | NOP
C :0 x032E | 00 | NOP
C :0 x032F | 00 | NOP
C :0 x0330 | 00 | NOP
C :0 x0331 | 00 | NOP
C :0 x0332 | 00 | NOP
C :0 x0333 | 00 | NOP
C :0 x0334 | 00 | NOP
C :0 x0335 | 00 | NOP
C :0 x0336 | 00 | NOP
C :0 x0337 | 00 | NOP
C :0 x0338 | 00 | NOP
C :0 x0339 | 00 | NOP
C :0 x033A | 00 | NOP
C :0 x033B | 00 | NOP
C :0 x033C | 00 | NOP
C :0 x033D | 00 | NOP
C :0 x033E | 00 | NOP
C :0 x033F | 00 | NOP
C :0 x0340 | 00 | NOP
C :0 x0341 | 00 | NOP
C :0 x0342 | 00 | NOP
C :0 x0343 | 00 | NOP
C :0 x0344 | 00 | NOP
C :0 x0345 | 00 | NOP
C :0 x0346 | 00 | NOP
C :0 x0347 | 00 | NOP
C :0 x0348 | 00 | NOP
C :0 x0349 | 00 | NOP
C :0 x034A | 00 | NOP
C :0 x034B | 00 | NOP
C :0 x034C | 00 | NOP
C :0 x034D | 00 | NOP
C :0 x034E | 00 | NOP
C :0 x034F | 00 | NOP
C :0 x0350 | 00 | NOP
C :0 x0351 | 00 | NOP
C :0 x0352 | 00 | NOP
C :0 x0353 | 00 | NOP
C :0 x0354 | 00 | NOP
C :0 x0355 | 00 | NOP
C :0 x0356 | 00 | NOP
C :0 x0357 | 00 | NOP
C :0 x0358 | 00 | NOP
C :0 x0359 | 00 | NOP
C :0 x035A | 00 | NOP
C :0 x035B | 00 | NOP
C :0 x035C | 00 | NOP
C :0 x035D | 00 | NOP
C :0 x035E | 00 | NOP
C :0 x035F | 00 | NOP
C :0 x0360 | 00 | NOP
C :0 x0361 | 00 | NOP
C :0 x0362 | 00 | NOP
C :0 x0363 | 00 | NOP
C :0 x0364 | 00 | NOP
C :0 x0365 | 00 | NOP
C :0 x0366 | 00 | NOP
C :0 x0367 | 00 | NOP
C :0 x0368 | 00 | NOP
C :0 x0369 | 00 | NOP
C :0 x036A | 00 | NOP
C :0 x036B | 00 | NOP
C :0 x036C | 00 | NOP
C :0 x036D | 00 | NOP
C :0 x036E | 00 | NOP
C :0 x036F | 00 | NOP
C :0 x0370 | 00 | NOP
C :0 x0371 | 00 | NOP
C :0 x0372 | 00 | NOP
C :0 x0373 | 00 | NOP
C :0 x0374 | 00 | NOP
C :0 x0375 | 00 | NOP
C :0 x0376 | 00 | NOP
C :0 x0377 | 00 | NOP
C :0 x0378 | 00 | NOP
C :0 x0379 | 00 | NOP
C :0 x037A | 00 | NOP
C :0 x037B | 00 | NOP
C :0 x037C | 00 | NOP
C :0 x037D | 00 | NOP
C :0 x037E | 00 | NOP
C :0 x037F | 00 | NOP

C :0 x0380 | 00 | NOP
C :0 x0381 | 00 | NOP
C :0 x0382 | 00 | NOP
C :0 x0383 | 00 | NOP
C :0 x0384 | 00 | NOP
C :0 x0385 | 00 | NOP
C :0 x0386 | 00 | NOP
C :0 x0387 | 00 | NOP
C :0 x0388 | 00 | NOP
C :0 x0389 | 00 | NOP
C :0 x038A | 00 | NOP
C :0 x038B | 00 | NOP
C :0 x038C | 00 | NOP
C :0 x038D | 00 | NOP
C :0 x038E | 00 | NOP
C :0 x038F | 00 | NOP
C :0 x0390 | 00 | NOP
C :0 x0391 | 00 | NOP
C :0 x0392 | 00 | NOP
C :0 x0393 | 00 | NOP
C :0 x0394 | 00 | NOP
C :0 x0395 | 00 | NOP
C :0 x0396 | 00 | NOP
C :0 x0397 | 00 | NOP
C :0 x0398 | 00 | NOP
C :0 x0399 | 00 | NOP
C :0 x039A | 00 | NOP
C :0 x039B | 00 | NOP
C :0 x039C | 00 | NOP
C :0 x039D | 00 | NOP
C :0 x039E | 00 | NOP
C :0 x039F | 00 | NOP
C :0 x03A0 | 00 | NOP
C :0 x03A1 | 00 | NOP
C :0 x03A2 | 00 | NOP
C :0 x03A3 | 00 | NOP
C :0 x03A4 | 00 | NOP
C :0 x03A5 | 00 | NOP
C :0 x03A6 | 00 | NOP
C :0 x03A7 | 00 | NOP
C :0 x03A8 | 00 | NOP
C :0 x03A9 | 00 | NOP
C :0 x03AA | 00 | NOP
C :0 x03AB | 00 | NOP
C :0 x03AC | 00 | NOP
C :0 x03AD | 00 | NOP
C :0 x03AE | 00 | NOP
C :0 x03AF | 00 | NOP
C :0 x03B0 | 00 | NOP
C :0 x03B1 | 00 | NOP
C :0 x03B2 | 00 | NOP
C :0 x03B3 | 00 | NOP
C :0 x03B4 | 00 | NOP
C :0 x03B5 | 00 | NOP
C :0 x03B6 | 00 | NOP
C :0 x03B7 | 00 | NOP
C :0 x03B8 | 00 | NOP
C :0 x03B9 | 00 | NOP
C :0 x03BA | 00 | NOP
C :0 x03BB | 00 | NOP
C :0 x03BC | 00 | NOP
C :0 x03BD | 00 | NOP
C :0 x03BE | 00 | NOP
C :0 x03BF | 00 | NOP
C :0 x03C0 | 00 | NOP
C :0 x03C1 | 00 | NOP
C :0 x03C2 | 00 | NOP
C :0 x03C3 | 00 | NOP
C :0 x03C4 | 00 | NOP
C :0 x03C5 | 00 | NOP
C :0 x03C6 | 00 | NOP
C :0 x03C7 | 00 | NOP
C :0 x03C8 | 00 | NOP
C :0 x03C9 | 00 | NOP
C :0 x03CA | 00 | NOP
C :0 x03CB | 00 | NOP
C :0 x03CC | 00 | NOP
C :0 x03CD | 00 | NOP
C :0 x03CE | 00 | NOP
C :0 x03CF | 00 | NOP
C :0 x03D0 | 00 | NOP
C :0 x03D1 | 00 | NOP
C :0 x03D2 | 00 | NOP
C :0 x03D3 | 00 | NOP
C :0 x03D4 | 00 | NOP
C :0 x03D5 | 00 | NOP
C :0 x03D6 | 00 | NOP
C :0 x03D7 | 00 | NOP
C :0 x03D8 | 00 | NOP
C :0 x03D9 | 00 | NOP
C :0 x03DA | 00 | NOP
C :0 x03DB | 00 | NOP
C :0 x03DC | 00 | NOP
C :0 x03DD | 00 | NOP
C :0 x03DE | 00 | NOP
C :0 x03DF | 00 | NOP
C :0 x03E0 | 00 | NOP
C :0 x03E1 | 00 | NOP
C :0 x03E2 | 00 | NOP

C :0 x03E3 | 00 | NOP
C :0 x03E4 | 00 | NOP
C :0 x03E5 | 00 | NOP
C :0 x03E6 | 00 | NOP
C :0 x03E7 | 00 | NOP
C :0 x03E8 | 00 | NOP
C :0 x03E9 | 00 | NOP
C :0 x03EA | 00 | NOP
C :0 x03EB | 00 | NOP
C :0 x03EC | 00 | NOP
C :0 x03ED | 00 | NOP
C :0 x03EE | 00 | NOP
C :0 x03EF | 00 | NOP
C :0 x03F0 | 00 | NOP
C :0 x03F1 | 00 | NOP
C :0 x03F2 | 00 | NOP
C :0 x03F3 | 00 | NOP
C :0 x03F4 | 00 | NOP
C :0 x03F5 | 00 | NOP
C :0 x03F6 | 00 | NOP
C :0 x03F7 | 00 | NOP
C :0 x03F8 | 00 | NOP
C :0 x03F9 | 00 | NOP
C :0 x03FA | 00 | NOP
C :0 x03FB | 00 | NOP
C :0 x03FC | 00 | NOP
C :0 x03FD | 00 | NOP
C :0 x03FE | 00 | NOP
C :0 x03FF | 00 | NOP
C :0 x0400 | 00 | NOP
C :0 x0401 | 00 | NOP
C :0 x0402 | 00 | NOP
C :0 x0403 | 00 | NOP
C :0 x0404 | 00 | NOP
C :0 x0405 | 00 | NOP
C :0 x0406 | 00 | NOP
C :0 x0407 | 00 | NOP
C :0 x0408 | 00 | NOP
C :0 x0409 | 00 | NOP
C :0 x040A | 00 | NOP
C :0 x040B | 00 | NOP
C :0 x040C | 00 | NOP
C :0 x040D | 00 | NOP
C :0 x040E | 00 | NOP
C :0 x040F | 00 | NOP
C :0 x0410 | 00 | NOP
C :0 x0411 | 00 | NOP
C :0 x0412 | 00 | NOP
C :0 x0413 | 00 | NOP
C :0 x0414 | 00 | NOP
C :0 x0415 | 00 | NOP
C :0 x0416 | 00 | NOP
C :0 x0417 | 00 | NOP
C :0 x0418 | 00 | NOP
C :0 x0419 | 00 | NOP
C :0 x041A | 00 | NOP
C :0 x041B | 00 | NOP
C :0 x041C | 00 | NOP
C :0 x041D | 00 | NOP
C :0 x041E | 00 | NOP
C :0 x041F | 00 | NOP
C :0 x0420 | 00 | NOP
C :0 x0421 | 00 | NOP
C :0 x0422 | 00 | NOP
C :0 x0423 | 00 | NOP
C :0 x0424 | 00 | NOP
C :0 x0425 | 00 | NOP
C :0 x0426 | 00 | NOP
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
C :0 x049C | 00 | NOP
C :0 x049D | 00 | NOP
C :0 x049E | 00 | NOP
C :0 x049F | 00 | NOP
C :0 x04A0 | 00 | NOP
C :0 x04A1 | 00 | NOP
C :0 x04A2 | 00 | NOP
C :0 x04A3 | 00 | NOP
C :0 x04A4 | 00 | NOP
C :0 x04A5 | 00 | NOP
C :0 x04A6 | 00 | NOP
C :0 x04A7 | 00 | NOP
C :0 x04A8 | 00 | NOP

C :0 x04A9 | 00 | NOP
C :0 x04AA | 00 | NOP
C :0 x04AB | 00 | NOP
C :0 x04AC | 00 | NOP
C :0 x04AD | 00 | NOP
C :0 x04AE | 00 | NOP
C :0 x04AF | 00 | NOP
C :0 x04B0 | 00 | NOP
C :0 x04B1 | 00 | NOP
C :0 x04B2 | 00 | NOP
C :0 x04B3 | 00 | NOP
C :0 x04B4 | 00 | NOP
C :0 x04B5 | 00 | NOP
C :0 x04B6 | 00 | NOP
C :0 x04B7 | 00 | NOP
C :0 x04B8 | 00 | NOP
C :0 x04B9 | 00 | NOP
C :0 x04BA | 00 | NOP
C :0 x04BB | 00 | NOP
C :0 x04BC | 00 | NOP
C :0 x04BD | 00 | NOP
C :0 x04BE | 00 | NOP
C :0 x04BF | 00 | NOP
C :0 x04C0 | 00 | NOP
C :0 x04C1 | 00 | NOP
C :0 x04C2 | 00 | NOP
C :0 x04C3 | 00 | NOP
C :0 x04C4 | 00 | NOP
C :0 x04C5 | 00 | NOP
C :0 x04C6 | 00 | NOP
C :0 x04C7 | 00 | NOP
C :0 x04C8 | 00 | NOP
C :0 x04C9 | 00 | NOP
C :0 x04CA | 00 | NOP
C :0 x04CB | 00 | NOP
C :0 x04CC | 00 | NOP
C :0 x04CD | 00 | NOP
C :0 x04CE | 00 | NOP
C :0 x04CF | 00 | NOP
C :0 x04D0 | 00 | NOP
C :0 x04D1 | 00 | NOP
C :0 x04D2 | 00 | NOP
C :0 x04D3 | 00 | NOP
C :0 x04D4 | 00 | NOP
C :0 x04D5 | 00 | NOP
C :0 x04D6 | 00 | NOP
C :0 x04D7 | 00 | NOP
C :0 x04D8 | 00 | NOP
C :0 x04D9 | 00 | NOP
C :0 x04DA | 00 | NOP
C :0 x04DB | 00 | NOP
C :0 x04DC | 00 | NOP
C :0 x04DD | 00 | NOP
C :0 x04DE | 00 | NOP
C :0 x04DF | 00 | NOP
C :0 x04E0 | 00 | NOP
C :0 x04E1 | 00 | NOP
C :0 x04E2 | 00 | NOP
C :0 x04E3 | 00 | NOP
C :0 x04E4 | 00 | NOP
C :0 x04E5 | 00 | NOP
C :0 x04E6 | 00 | NOP
C :0 x04E7 | 00 | NOP
C :0 x04E8 | 00 | NOP
C :0 x04E9 | 00 | NOP
C :0 x04EA | 00 | NOP
C :0 x04EB | 00 | NOP
C :0 x04EC | 00 | NOP
C :0 x04ED | 00 | NOP
C :0 x04EE | 00 | NOP
C :0 x04EF | 00 | NOP
C :0 x04F0 | 00 | NOP
C :0 x04F1 | 00 | NOP
C :0 x04F2 | 00 | NOP
C :0 x04F3 | 00 | NOP
C :0 x04F4 | 00 | NOP
C :0 x04F5 | 00 | NOP
C :0 x04F6 | 00 | NOP
C :0 x04F7 | 00 | NOP
C :0 x04F8 | 00 | NOP
C :0 x04F9 | 00 | NOP
C :0 x04FA | 00 | NOP
C :0 x04FB | 00 | NOP
C :0 x04FC | 00 | NOP
C :0 x04FD | 00 | NOP
C :0 x04FE | 00 | NOP
C :0 x04FF | 00 | NOP
C :0 x0500 | 00 | NOP
C :0 x0501 | 00 | NOP
C :0 x0502 | 00 | NOP
C :0 x0503 | 00 | NOP
C :0 x0504 | 00 | NOP
C :0 x0505 | 00 | NOP
C :0 x0506 | 00 | NOP
C :0 x0507 | 00 | NOP
C :0 x0508 | 00 | NOP
C :0 x0509 | 00 | NOP
C :0 x050A | 00 | NOP
C :0 x050B | 00 | NOP

C :0 x050C | 00 | NOP
C :0 x050D | 00 | NOP
C :0 x050E | 00 | NOP
C :0 x050F | 00 | NOP
C :0 x0510 | 00 | NOP
C :0 x0511 | 00 | NOP
C :0 x0512 | 00 | NOP
C :0 x0513 | 00 | NOP
C :0 x0514 | 00 | NOP
C :0 x0515 | 00 | NOP
C :0 x0516 | 00 | NOP
C :0 x0517 | 00 | NOP
C :0 x0518 | 00 | NOP
C :0 x0519 | 00 | NOP
C :0 x051A | 00 | NOP
C :0 x051B | 00 | NOP
C :0 x051C | 00 | NOP
C :0 x051D | 00 | NOP
C :0 x051E | 00 | NOP
C :0 x051F | 00 | NOP
C :0 x0520 | 00 | NOP
C :0 x0521 | 00 | NOP
C :0 x0522 | 00 | NOP
C :0 x0523 | 00 | NOP
C :0 x0524 | 00 | NOP
C :0 x0525 | 00 | NOP
C :0 x0526 | 00 | NOP
C :0 x0527 | 00 | NOP
C :0 x0528 | 00 | NOP
C :0 x0529 | 00 | NOP
C :0 x052A | 00 | NOP
C :0 x052B | 00 | NOP
C :0 x052C | 00 | NOP
C :0 x052D | 00 | NOP
C :0 x052E | 00 | NOP
C :0 x052F | 00 | NOP
C :0 x0530 | 00 | NOP
C :0 x0531 | 00 | NOP
C :0 x0532 | 00 | NOP
C :0 x0533 | 00 | NOP
C :0 x0534 | 00 | NOP
C :0 x0535 | 00 | NOP
C :0 x0536 | 00 | NOP
C :0 x0537 | 00 | NOP
C :0 x0538 | 00 | NOP
C :0 x0539 | 00 | NOP
C :0 x053A | 00 | NOP
C :0 x053B | 00 | NOP
C :0 x053C | 00 | NOP
C :0 x053D | 00 | NOP
C :0 x053E | 00 | NOP
C :0 x053F | 00 | NOP
C :0 x0540 | 00 | NOP
C :0 x0541 | 00 | NOP
C :0 x0542 | 00 | NOP
C :0 x0543 | 00 | NOP
C :0 x0544 | 00 | NOP
C :0 x0545 | 00 | NOP
C :0 x0546 | 00 | NOP
C :0 x0547 | 00 | NOP
C :0 x0548 | 00 | NOP
C :0 x0549 | 00 | NOP
C :0 x054A | 00 | NOP
C :0 x054B | 00 | NOP
C :0 x054C | 00 | NOP
C :0 x054D | 00 | NOP
C :0 x054E | 00 | NOP
C :0 x054F | 00 | NOP
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
C :0 x068B | 00 | NOP
C :0 x068C | 00 | NOP
C :0 x068D | 00 | NOP
C :0 x068E | 00 | NOP
C :0 x068F | 00 | NOP
C :0 x0690 | 00 | NOP
C :0 x0691 | 00 | NOP
C :0 x0692 | 00 | NOP
C :0 x0693 | 00 | NOP
C :0 x0694 | 00 | NOP
C :0 x0695 | 00 | NOP
C :0 x0696 | 00 | NOP
C :0 x0697 | 00 | NOP

C :0 x0698 | 00 | NOP
C :0 x0699 | 00 | NOP
C :0 x069A | 00 | NOP
C :0 x069B | 00 | NOP
C :0 x069C | 00 | NOP
C :0 x069D | 00 | NOP
C :0 x069E | 00 | NOP
C :0 x069F | 00 | NOP
C :0 x06A0 | 00 | NOP
C :0 x06A1 | 00 | NOP
C :0 x06A2 | 00 | NOP
C :0 x06A3 | 00 | NOP
C :0 x06A4 | 00 | NOP
C :0 x06A5 | 00 | NOP
C :0 x06A6 | 00 | NOP
C :0 x06A7 | 00 | NOP
C :0 x06A8 | 00 | NOP
C :0 x06A9 | 00 | NOP
C :0 x06AA | 00 | NOP
C :0 x06AB | 00 | NOP
C :0 x06AC | 00 | NOP
C :0 x06AD | 00 | NOP
C :0 x06AE | 00 | NOP
C :0 x06AF | 00 | NOP
C :0 x06B0 | 00 | NOP
C :0 x06B1 | 00 | NOP
C :0 x06B2 | 00 | NOP
C :0 x06B3 | 00 | NOP
C :0 x06B4 | 00 | NOP
C :0 x06B5 | 00 | NOP
C :0 x06B6 | 00 | NOP
C :0 x06B7 | 00 | NOP
C :0 x06B8 | 00 | NOP
C :0 x06B9 | 00 | NOP
C :0 x06BA | 00 | NOP
C :0 x06BB | 00 | NOP
C :0 x06BC | 00 | NOP
C :0 x06BD | 00 | NOP
C :0 x06BE | 00 | NOP
C :0 x06BF | 00 | NOP
C :0 x06C0 | 00 | NOP
C :0 x06C1 | 00 | NOP
C :0 x06C2 | 00 | NOP
C :0 x06C3 | 00 | NOP
C :0 x06C4 | 00 | NOP
C :0 x06C5 | 00 | NOP
C :0 x06C6 | 00 | NOP
C :0 x06C7 | 00 | NOP
C :0 x06C8 | 00 | NOP
C :0 x06C9 | 00 | NOP
C :0 x06CA | 00 | NOP
C :0 x06CB | 00 | NOP
C :0 x06CC | 00 | NOP
C :0 x06CD | 00 | NOP
C :0 x06CE | 00 | NOP
C :0 x06CF | 00 | NOP
C :0 x06D0 | 00 | NOP
C :0 x06D1 | 00 | NOP
C :0 x06D2 | 00 | NOP
C :0 x06D3 | 00 | NOP
C :0 x06D4 | 00 | NOP
C :0 x06D5 | 00 | NOP
C :0 x06D6 | 00 | NOP
C :0 x06D7 | 00 | NOP
C :0 x06D8 | 00 | NOP
C :0 x06D9 | 00 | NOP
C :0 x06DA | 00 | NOP
C :0 x06DB | 00 | NOP
C :0 x06DC | 00 | NOP
C :0 x06DD | 00 | NOP
C :0 x06DE | 00 | NOP
C :0 x06DF | 00 | NOP
C :0 x06E0 | 00 | NOP
C :0 x06E1 | 00 | NOP
C :0 x06E2 | 00 | NOP
C :0 x06E3 | 00 | NOP
C :0 x06E4 | 00 | NOP
C :0 x06E5 | 00 | NOP
C :0 x06E6 | 00 | NOP
C :0 x06E7 | 00 | NOP
C :0 x06E8 | 00 | NOP
C :0 x06E9 | 00 | NOP
C :0 x06EA | 00 | NOP
C :0 x06EB | 00 | NOP
C :0 x06EC | 00 | NOP
C :0 x06ED | 00 | NOP
C :0 x06EE | 00 | NOP
C :0 x06EF | 00 | NOP
C :0 x06F0 | 00 | NOP
C :0 x06F1 | 00 | NOP
C :0 x06F2 | 00 | NOP
C :0 x06F3 | 00 | NOP
C :0 x06F4 | 00 | NOP
C :0 x06F5 | 00 | NOP
C :0 x06F6 | 00 | NOP
C :0 x06F7 | 00 | NOP
C :0 x06F8 | 00 | NOP
C :0 x06F9 | 00 | NOP
C :0 x06FA | 00 | NOP

C :0 x06FB | 00 | NOP
C :0 x06FC | 00 | NOP
C :0 x06FD | 00 | NOP
C :0 x06FE | 00 | NOP
C :0 x06FF | 00 | NOP
C :0 x0700 | 00 | NOP
C :0 x0701 | 00 | NOP
C :0 x0702 | 00 | NOP
C :0 x0703 | 00 | NOP
C :0 x0704 | 00 | NOP
C :0 x0705 | 00 | NOP
C :0 x0706 | 00 | NOP
C :0 x0707 | 00 | NOP
C :0 x0708 | 00 | NOP
C :0 x0709 | 00 | NOP
C :0 x070A | 00 | NOP
C :0 x070B | 00 | NOP
C :0 x070C | 00 | NOP
C :0 x070D | 00 | NOP
C :0 x070E | 00 | NOP
C :0 x070F | 00 | NOP
C :0 x0710 | 00 | NOP
C :0 x0711 | 00 | NOP
C :0 x0712 | 00 | NOP
C :0 x0713 | 00 | NOP
C :0 x0714 | 00 | NOP
C :0 x0715 | 00 | NOP
C :0 x0716 | 00 | NOP
C :0 x0717 | 00 | NOP
C :0 x0718 | 00 | NOP
C :0 x0719 | 00 | NOP
C :0 x071A | 00 | NOP
C :0 x071B | 00 | NOP
C :0 x071C | 00 | NOP
C :0 x071D | 00 | NOP
C :0 x071E | 00 | NOP
C :0 x071F | 00 | NOP
C :0 x0720 | 00 | NOP
C :0 x0721 | 00 | NOP
C :0 x0722 | 00 | NOP
C :0 x0723 | 00 | NOP
C :0 x0724 | 00 | NOP
C :0 x0725 | 00 | NOP
C :0 x0726 | 00 | NOP
C :0 x0727 | 00 | NOP
C :0 x0728 | 00 | NOP
C :0 x0729 | 00 | NOP
C :0 x072A | 00 | NOP
C :0 x072B | 00 | NOP
C :0 x072C | 00 | NOP
C :0 x072D | 00 | NOP
C :0 x072E | 00 | NOP
C :0 x072F | 00 | NOP
C :0 x0730 | 00 | NOP
C :0 x0731 | 00 | NOP
C :0 x0732 | 00 | NOP
C :0 x0733 | 00 | NOP
C :0 x0734 | 00 | NOP
C :0 x0735 | 00 | NOP
C :0 x0736 | 00 | NOP
C :0 x0737 | 00 | NOP
C :0 x0738 | 00 | NOP
C :0 x0739 | 00 | NOP
C :0 x073A | 00 | NOP
C :0 x073B | 00 | NOP
C :0 x073C | 00 | NOP
C :0 x073D | 00 | NOP
C :0 x073E | 00 | NOP
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
C :0 x07B4 | 00 | NOP
C :0 x07B5 | 00 | NOP
C :0 x07B6 | 00 | NOP
C :0 x07B7 | 00 | NOP
C :0 x07B8 | 00 | NOP
C :0 x07B9 | 00 | NOP
C :0 x07BA | 00 | NOP
C :0 x07BB | 00 | NOP
C :0 x07BC | 00 | NOP
C :0 x07BD | 00 | NOP
C :0 x07BE | 00 | NOP
C :0 x07BF | 00 | NOP
C :0 x07C0 | 00 | NOP

C :0 x07C1 | 00 | NOP
C :0 x07C2 | 00 | NOP
C :0 x07C3 | 00 | NOP
C :0 x07C4 | 00 | NOP
C :0 x07C5 | 00 | NOP
C :0 x07C6 | 00 | NOP
C :0 x07C7 | 00 | NOP
C :0 x07C8 | 00 | NOP
C :0 x07C9 | 00 | NOP
C :0 x07CA | 00 | NOP
C :0 x07CB | 00 | NOP
C :0 x07CC | 00 | NOP
C :0 x07CD | 00 | NOP
C :0 x07CE | 00 | NOP
C :0 x07CF | 00 | NOP
C :0 x07D0 | 00 | NOP
C :0 x07D1 | 00 | NOP
C :0 x07D2 | 00 | NOP
C :0 x07D3 | 00 | NOP
C :0 x07D4 | 00 | NOP
C :0 x07D5 | 00 | NOP
C :0 x07D6 | 00 | NOP
C :0 x07D7 | 00 | NOP
C :0 x07D8 | 00 | NOP
C :0 x07D9 | 00 | NOP
C :0 x07DA | 00 | NOP
C :0 x07DB | 00 | NOP
C :0 x07DC | 00 | NOP
C :0 x07DD | 00 | NOP
C :0 x07DE | 00 | NOP
C :0 x07DF | 00 | NOP
C :0 x07E0 | 00 | NOP
C :0 x07E1 | 00 | NOP
C :0 x07E2 | 00 | NOP
C :0 x07E3 | 00 | NOP
C :0 x07E4 | 00 | NOP
C :0 x07E5 | 00 | NOP
C :0 x07E6 | 00 | NOP
C :0 x07E7 | 00 | NOP
C :0 x07E8 | 00 | NOP
C :0 x07E9 | 00 | NOP
C :0 x07EA | 00 | NOP
C :0 x07EB | 00 | NOP
C :0 x07EC | 00 | NOP
C :0 x07ED | 00 | NOP
C :0 x07EE | 00 | NOP
C :0 x07EF | 00 | NOP
C :0 x07F0 | 00 | NOP
C :0 x07F1 | 00 | NOP
C :0 x07F2 | 00 | NOP
C :0 x07F3 | 00 | NOP
C :0 x07F4 | 00 | NOP
C :0 x07F5 | 00 | NOP
C :0 x07F6 | 00 | NOP
C :0 x07F7 | 00 | NOP
C :0 x07F8 | 00 | NOP
C :0 x07F9 | 00 | NOP
C :0 x07FA | 00 | NOP
C :0 x07FB | 00 | NOP
C :0 x07FC | 00 | NOP
C :0 x07FD | 00 | NOP
C :0 x07FE | 00 | NOP
C :0 x07FF | 00 | NOP
71: void main ( void ){
72: | // Start of peripheral setup
73: | U8 TCON_save ;
74: | // Watchdog
75: | WDTCN = 0 xDE ; | // First key
C :0 x0800 | 7597 DE | MOV | WDTCN (0 x97 ) ,#0 xDE
76: | WDTCN = 0 xAD ; | // Second key - Watchdog now disabled
77: | // Clock
C :0 x0803 | 7597 AD | MOV | WDTCN (0 x97 ) ,#0 xAD
78: | CLKSEL =
79: | CLKSEL_CLKSL__HFOSC | | | // Use 24.5 MHz interal clock
80: | CLKSEL_CLKDIV__SYSCLK_DIV_1 ; | // Do not divide
81: | // Port 0
C :0 x0806 | E4 | CLR | A
C :0 x0807 | F5A9 | MOV | CLKSEL (0 xA9 ), A
82: | P0MDOUT =
83: | P0MDOUT_B0__PUSH_PULL | | | // PWM1 output
84: | P0MDOUT_B1__PUSH_PULL | | | // PWM2 output
85: | P0MDOUT_B2__OPEN_DRAIN | |
86: | P0MDOUT_B3__OPEN_DRAIN | |
87: | P0MDOUT_B4__PUSH_PULL | | | // UART TX
88: | P0MDOUT_B5__OPEN_DRAIN | | | // UART RX
89: | P0MDOUT_B6__OPEN_DRAIN | |
90: | P0MDOUT_B7__OPEN_DRAIN ;
91: | // Port 1
C :0 x0809 | 75 A413 | MOV | P0MDOUT (0 xA4 ) ,#0 x13
92: | P1MDOUT =
93: | P1MDOUT_B0__OPEN_DRAIN | |
94: | P1MDOUT_B1__OPEN_DRAIN | |
95: | P1MDOUT_B2__OPEN_DRAIN | |
96: | P1MDOUT_B3__PUSH_PULL | | | // TEST2
97: | P1MDOUT_B4__PUSH_PULL | | | // TEST1
98: | P1MDOUT_B5__OPEN_DRAIN | |
99: | P1MDOUT_B6__OPEN_DRAIN | |
100: | P1MDOUT_B7__OPEN_DRAIN ;
C :0 x080C | 75 A518 | MOV | P1MDOUT (0 xA5 ) ,#0 x18

101: | P1MDIN =
102: | P1MDIN_B0__ANALOG
| | // ADC1
103: | P1MDIN_B1__ANALOG
| | // ADC2
104: | P1MDIN_B2__ANALOG
| | // ADC3
105: | P1MDIN_B3__DIGITAL
106: | P1MDIN_B4__DIGITAL
107: | P1MDIN_B5__DIGITAL
108: | P1MDIN_B6__DIGITAL
109: | P1MDIN_B7__DIGITAL ;
110: | // Port crossbar
C :0 x080F | 75 F2F8 | MOV | P1MDIN (0 xF2 ) ,#0 xF8
111: | XBR0 =
112: | XBR0_URT0E__ENABLED | | | // Route out UART
113: | XBR0_SPI0E__DISABLED | |
114: | XBR0_SMB0E__DISABLED | |
115: | XBR0_CP0E__DISABLED | |
116: | XBR0_CP0AE__DISABLED | |
117: | XBR0_CP1E__DISABLED
118: | XBR0_CP1AE__DISABLED | |
119: | XBR0_SYSCKE__DISABLED ;
C :0 x0812 | 75 E101 | MOV | XBR0 (0 xE1 ) ,#0 x01
120: | XBR1 =
121: | XBR1_PCA0ME__CEX0_CEX1 | | | // Route out PCA0 and PCA1
122: | XBR1_ECIE__DISABLED | |
123: | XBR1_T0E__DISABLED
124: | XBR1_T1E__DISABLED
125: | XBR1_T2E__DISABLED ;
C :0 x0815 | 75 E202 | MOV | XBR1 (0 xE2 ) ,#0 x02
126: | XBR2 =
127: | XBR2_WEAKPUD__PULL_UPS_ENABLED | | | // Weak pull ups
128: | XBR2_XBARE__ENABLED ; | // Enable cross bar
129: | // ADC
130: | // ADC0MX =
// Mux set in application
131: | // | ADC0MX_ADC0MX__ADC0P10 ;
C :0 x0818 | 75 E340 | MOV | XBR2 (0 xE3 ) ,#0 x40
132: | ADC0CF =
133: | (1 << ADC0CF_ADSC__SHIFT )
134: | ADC0CF_AD8BE__NORMAL | | | // ADC set to 10 bit
135: | ADC0CF_ADGN__GAIN_1 | | | // ADC gain set to 1
136: | ADC0CF_ADTM__TRACK_NORMAL ;
// Immediate covert
C :0 x081B | 75 BC09 | MOV | ADC0CF (0 xBC ) ,#0 x09
137: | ADC0CN0 &=
138: | ~ ADC0CN0_ADCM__FMASK ;
C :0 x081E | 53 E8F8 | ANL | ADC0CN0 (0 xE8 ) ,#0 xF8
139: | ADC0CN0 |=
140: | ADC0CN0_ADEN__ENABLED | |
141: | ADC0CN0_ADCM__ADBUSY ;
142: | // Timer 0
C :0 x0821 | 43 E880 | ORL | ADC0CN0 (0 xE8 ) ,#0 x80
143: | TCON_save = TCON ;
C :0 x0824 | AF88 | MOV | R7 , TCON (0 x88 )
144: | TCON &=
145: | TCON_TR0__BMASK
&
146: | TCON_TR1__BMASK ;
C :0 x0826 | F588 | MOV | TCON (0 x88 ),A
147: | TH1 = (150 << TH1_TH1__SHIFT );
C :0 x0828 | 758 D96 | MOV | TH1 (0 x8D ) ,#0 x96
148: | TL1 = (150 << TL1_TL1__SHIFT );
C :0 x082B | 758 B96 | MOV | TL1 (0 x8B ) ,#0 x96
149: | TCON =
150: | TCON_save ;
151: | // Timer setup
C :0 x082E | 8 F88 | MOV | TCON (0 x88 ), R7
152: | CKCON =
153: | CKCON_SCA__SYSCLK_DIV_12
154: | CKCON_T0M__PRESCALE | |
155: | CKCON_T3MH__EXTERNAL_CLOCK | |
156: | CKCON_T3ML__EXTERNAL_CLOCK
157: | CKCON_T1M__SYSCLK ;
C :0 x0830 | 758 E08 | MOV | CKCON (0 x8E ) ,#0 x08
158: | TMOD =
159: | TMOD_T0M__MODE0
160: | TMOD_CT0__TIMER
161: | TMOD_GATE0__DISABLED | |
162: | TMOD_T1M__MODE2
163: | TMOD_CT1__TIMER
164: | TMOD_GATE1__DISABLED ;
C :0 x0833 | 758920 | MOV | TMOD (0 x89 ) ,#0 x20
165: | TCON |=

166: | TCON_TR1__RUN ;
167: | // UART
C :0 x0836 | 438840 | ORL | TCON (0 x88 ) ,#0 x40
168: | SCON0 |=
169: | SCON0_REN__RECEIVE_ENABLED ;
170: | // VREF
C :0 x0839 | 439810 | ORL | SCON0 (0 x98 ) ,#0 x10
171: | REF0CN =
172: | REF0CN_REFSL__VDD_PIN | |
173: | REF0CN_IREFLVL__1P65 | |
174: | REF0CN_GNDSL__GND_PIN | |
175: | REF0CN_TEMPE__TEMP_DISABLED ;
176: | // RSTSRC
C :0 x083C | 75 D108 | MOV | REF0CN (0 xD1 ) ,#0 x08
177: | RSTSRC =
178: | RSTSRC_C0RSEF__NOT_SET | |
179: | RSTSRC_MCDRSF__SET
180: | RSTSRC_PORSF__SET
181: | RSTSRC_SWRSF__NOT_SET ;
182: | // Interrupt
C :0 x083F | 75 EF06 | MOV | RSTSRC (0 xEF ) ,#0 x06
183: | IE =
184: | IE_EA__ENABLED | |
185: | IE_EX0__DISABLED
186: | IE_EX1__DISABLED
187: | IE_ESPI0__DISABLED
188: | IE_ET0__DISABLED
189: | IE_ET1__ENABLED | | | // Timer 1 enabled
190: | IE_ET2__ENABLED
| | // Timer 2 enabled
191: | IE_ES0__ENABLED ;
C :0 x0842 | 75 A8B8 | MOV | IE (0 xA8 ) ,# IP (0 xB8 )
192: | IP =
193: | IP_PX0__LOW | |
194: | IP_PX1__LOW | |
195: | IP_PSPI0__LOW | |
196: | IP_PT0__LOW | |
197: | IP_PT1__LOW
198: | IP_PT2__HIGH | | | // Timer 2 highest priority
199: | IP_PS0__LOW ;
200: | // PCA
C :0 x0845 | 75 B820 | MOV | IP (0 xB8 ) ,#0 x20
201: | PCA0CN_CR =
202: | PCA0CN_CR__STOP ;
C :0 x0848 | C2DE | CLR | PCA0CN_CR (0 xD8 .6)
203: | PCA0CPM0 =
204: | PCA0CPM0_CAPN__DISABLED
205: | PCA0CPM0_ECCF__ENABLED | |
206: | PCA0CPM0_MAT__ENABLED | |
207: | PCA0CPM0_CAPP__DISABLED
208: | PCA0CPM0_ECOM__ENABLED | |
209: | PCA0CPM0_PWM__ENABLED | |
210: | PCA0CPM0_TOG__DISABLED ;
C :0 x084A | 75 DA4B | MOV | PCA0CPM0 (0 xDA ) ,#0 x4B
211: | PCA0CPM1 =
212: | PCA0CPM1_CAPN__DISABLED
213: | PCA0CPM1_ECCF__ENABLED | |
214: | PCA0CPM1_MAT__ENABLED | |
215: | PCA0CPM1_CAPP__DISABLED
216: | PCA0CPM1_ECOM__ENABLED | |
217: | PCA0CPM1_PWM__ENABLED | |
218: | PCA0CPM1_TOG__DISABLED ;
C :0 x084D | 75 DB4B | MOV | PCA0CPM1 (0 xDB ) ,#0 x4B
219: | PCA0MD =
220: | PCA0MD_CIDL__NORMAL | |
221: | PCA0MD_ECF__OVF_INT_DISABLED | |
222: | PCA0MD_CPS__SYSCLK ;
C :0 x0850 | 75 D908 | MOV | PCA0MD (0 xD9 ) ,#0 x08
223: | PCA0CN |=
224: | PCA0CN_CR__RUN ;
225: | // Timer 2
C :0 x0853 | 43 D840 | ORL | PCA0CN (0 xD8 ) ,#0 x40
226: | TMR2CN |= TMR2CN_TR2__RUN ;
227: | // End of peripheral setup
228:
C :0 x0856 | 43 C804 | ORL | TMR2CN (0 xC8 ) ,#0 x04
229: | enabled | = false ;
C :0 x0859 | C202 | CLR | enabled (0 x20 .2)
230: | integral | = 0;
C :0 x085B | F52E | MOV | integral (0 x2E ),A
C :0 x085D | F52F | MOV | 0 x2F ,A
231: | target_mV | = DEFAULT_OUT_MV ;
C :0 x085F | 752513 | MOV | target_mV (0 x25 ) ,#0 x13
C :0 x0862 | 752688 | MOV | 0 x26 ,# TCON (0 x88 )
232: | high_mV | = DEFAULT_HIGH_MV ;
C :0 x0865 | 752717 | MOV | high_mV (0 x27 ) ,#0 x17
C :0 x0868 | 752870 | MOV | 0 x28 ,#0 x70
233: | low_mV | = DEFAULT_LOW_MV ;

234:
C :0 x086B | 75370 F | MOV | low_mV (0 x37 ) ,#0 x0F
C :0 x086E | 7538 A0 | MOV | 0 x38 ,#0 xA0
235: | SCON0_TI | = 1;
C :0 x0871 | D299 | SETB | SCON0_TI (0 x98 .1)
236: | SCON0_RI | = 0;
237:
C :0 x0873 | C298 | CLR | SCON0_RI (0 x98 .0)
238: | while (1){
239: | if ( SCON0_RI ){
C :0 x0875 | 3098 FD | JNB | SCON0_RI (0 x98 .0) , C :0875
240: | SCON0_RI = 0;
C :0 x0878 | C298 | CLR | SCON0_RI (0 x98 .0)
241: | uart_in [4] = uart_in [3];
// Small buffer , less code not to use loop
C :0 x087A | 853536 | MOV | 0 x36 ,0 x35
242: | uart_in [3] = uart_in [2];
C :0 x087D | 853435 | MOV | 0 x35 ,0 x34
243: | uart_in [2] = uart_in [1];
C :0 x0880 | 853334 | MOV | 0 x34 ,0 x33
244: | uart_in [1] = uart_in [0];
C :0 x0883 | 853233 | MOV | 0 x33 , uart_in (0 x32 )
245: | uart_in [0] = SBUF0 ;
246:
C :0 x0886 | 859932 | MOV | uart_in (0 x32 ), SBUF0 (0 x99 )
247: | uartLoadOut ( uart_in [0]);
248:
C :0 x0889 | AF32 | MOV | R7 , uart_in (0 x32 )
C :0 x088B | 120 B9C | LCALL | uartLoadOut (C :0 B9C )
249: | switch ( uart_in [0]){
C :0 x088E | E532 | MOV | A , uart_in (0 x32 )
C :0 x0890 | 120 AA6 | LCALL | C? CCASE (C :0 AA6 )
C :0 x0893 | 08 | INC | R0
C :0 x0894 | B56108 | CJNE | A ,0 x61 ,C :089 F
C :0 x0897 | BD6308 | CJNE | R5 ,#0 x63 ,C :08 A2
C :0 x089A | C564 | XCH | A ,0 x64
C :0 x089C | 08 | INC | R0
C :0 x089D | CD | XCH | A , R5
C :0 x089E | 67 | XRL | A , @R1
C :0 x089F | 08 | INC | R0
C :0 x08A0 | DA6D | DJNZ | R2 ,C :090 F
C :0 x08A2 | 08 | INC | R0
C :0 x08A3 | E2 | MOVX | A , @R0
C :0 x08A4 | 6E | XRL | A , R6
C :0 x08A5 | 08 | INC | R0
C :0 x08A6 | D6 | XCHD | A , @R0
C :0 x08A7 | 73 | JMP | @A + DPTR
C :0 x08A8 | 08 | INC | R0
C :0 x08A9 | EA | MOV | A , R2
C :0 x08AA | 7808 | MOV | R0 ,#0 x08
C :0 x08AC | F2 | MOVX | @R0 ,A
C :0 x08AD | 7908 | MOV | R1 ,#0 x08
C :0 x08AF | FA | MOV | R2 ,A
C :0 x08B0 | 7 A00 | MOV | R2 ,#0 x00
C :0 x08B2 | 00 | NOP
C :0 x08B3 | 09 | INC | R1
C :0 x08B4 | 06 | INC | @R0
250: | case ’a ’: | uartNumbers ( target_mV , true );
C :0 x08B5 | D200 | SETB | 0 x20 .0
C :0 x08B7 | AF26 | MOV | R7 ,0 x26
C :0 x08B9 | AE25 | MOV | R6 , target_mV (0 x25 )
251: | break ;
C :0 x08BB | 8043 | SJMP | C :0900
252: | case ’c ’: | uartNumbers ( current , true );
C :0 x08BD | D200 | SETB | 0 x20 .0
C :0 x08BF | AF22 | MOV | R7 ,0 x22
C :0 x08C1 | AE21 | MOV | R6 , current (0 x21 )
253: | break ;
C :0 x08C3 | 803 B | SJMP | C :0900
254: | case ’d ’: | uartNumbers ( duty , true );
C :0 x08C5 | AF29 | MOV | R7 , duty (0 x29 )
C :0 x08C7 | 7 E00 | MOV | R6 ,#0 x00
C :0 x08C9 | D200 | SETB | 0 x20 .0
255: | break ;
C :0 x08CB | 8033 | SJMP | C :0900
256: | case ’g ’: | enabled | = true ;
C :0 x08CD | D202 | SETB | enabled (0 x20 .2)
257: | integral
= 0;
C :0 x08CF | E4 | CLR | A
C :0 x08D0 | F52E | MOV | integral (0 x2E ),A
C :0 x08D2 | F52F | MOV | 0 x2F ,A
258: | break ;
C :0 x08D4 | 809 F | SJMP | C :0875
259: | case ’s ’: | enabled | = false ;
C :0 x08D6 | C202 | CLR | enabled (0 x20 .2)
260: | break ;
C :0 x08D8 | 809 B | SJMP | C :0875
261: | case ’m ’: | uartNumbers ( high_mV , true );
C :0 x08DA | D200 | SETB | 0 x20 .0
C :0 x08DC | AF28 | MOV | R7 ,0 x28
C :0 x08DE | AE27 | MOV | R6 , high_mV (0 x27 )
262: | break ;
C :0 x08E0 | 801 E | SJMP | C :0900
263: | case ’n ’: | uartNumbers ( low_mV , true );
C :0 x08E2 | D200 | SETB | 0 x20 .0
C :0 x08E4 | AF38 | MOV | R7 ,0 x38
C :0 x08E6 | AE37 | MOV | R6 , low_mV (0 x37 )
264: | break ;

C :0 x08E8 | 8016 | SJMP | C :0900
265: | case ’x ’: | uartNumbers ( adc1 , true );
C :0 x08EA | D200 | SETB | 0 x20 .0
C :0 x08EC | AF2B | MOV | R7 ,0 x2B
C :0 x08EE | AE2A | MOV | R6 , adc1 (0 x2A )
266: | break ;
C :0 x08F0 | 800 E | SJMP | C :0900
267: | case ’y ’: | uartNumbers ( adc2 , true );
C :0 x08F2 | D200 | SETB | 0 x20 .0
C :0 x08F4 | AF2D | MOV | R7 ,0 x2D
C :0 x08F6 | AE2C | MOV | R6 , adc2 (0 x2C )
268: | break ;
C :0 x08F8 | 8006 | SJMP | C :0900
269: | case ’z ’: | uartNumbers ( adc3 , true );
C :0 x08FA | D200 | SETB | 0 x20 .0
C :0 x08FC | AF31 | MOV | R7 ,0 x31
C :0 x08FE | AE30 | MOV | R6 , adc3 (0 x30 )
C :0 x0900 | 120 AF9 | LCALL | uartNumbers (C :0 AF9 )
270: | break ;
C :0 x0903 | 020875 | LJMP | C :0875
271: | default : | switch ( uart_in [4]){
C :0 x0906 | E536 | MOV | A ,0 x36
C :0 x0908 | 2494 | ADD | A ,#0 x94
C :0 x090A | 601 B | JZ | C :0927
C :0 x090C | 24 F6 | ADD | A ,#0 xF6
C :0 x090E | 6027 | JZ | C :0937
C :0 x0910 | 240 E | ADD | A ,#0 x0E
C :0 x0912 | 6003 | JZ | C :0917
C :0 x0914 | 020875 | LJMP | C :0875
272: | case ’h ’:
high_mV | = uartNumbers ( high_mV , false );
C :0 x0917 | C200 | CLR | 0 x20 .0
C :0 x0919 | AF28 | MOV | R7 ,0 x28
C :0 x091B | AE27 | MOV | R6 , high_mV (0 x27 )
C :0 x091D | 120 AF9 | LCALL | uartNumbers (C :0 AF9 )
C :0 x0920 | 8 E27 | MOV | high_mV (0 x27 ) , R6
C :0 x0922 | 8 F28 | MOV | 0 x28 , R7
273:
break ;
C :0 x0924 | 020875 | LJMP | C :0875
274: | case ’l ’:
low_mV | = uartNumbers ( low_mV , false );
C :0 x0927 | C200 | CLR | 0 x20 .0
C :0 x0929 | AF38 | MOV | R7 ,0 x38
C :0 x092B | AE37 | MOV | R6 , low_mV (0 x37 )
C :0 x092D | 120 AF9 | LCALL | uartNumbers (C :0 AF9 )
C :0 x0930 | 8 E37 | MOV | low_mV (0 x37 ), R6
C :0 x0932 | 8 F38 | MOV | 0 x38 , R7
275:
break ;
C :0 x0934 | 020875 | LJMP | C :0875
276: | case ’v ’:
target_mV | = uartNumbers ( target_mV , false );
C :0 x0937 | C200 | CLR | 0 x20 .0
C :0 x0939 | AF26 | MOV | R7 ,0 x26
C :0 x093B | AE25 | MOV | R6 , target_mV (0 x25 )
C :0 x093D | 120 AF9 | LCALL | uartNumbers (C :0 AF9 )
C :0 x0940 | 8 E25 | MOV | target_mV (0 x25 ), R6
C :0 x0942 | 8 F26 | MOV | 0 x26 , R7
277:
integral | = 0;
C :0 x0944 | E4 | CLR | A
C :0 x0945 | F52E | MOV | integral (0 x2E ),A
C :0 x0947 | F52F | MOV | 0 x2F ,A
278:
break ;
C :0 x0949 | 020875 | LJMP | C :0875
341: INTERRUPT ( TIMER2_ISR , TIMER2_IRQn ){ | // One timer handling UART Tx and PID
342: | int out ;
343: | int error ;
C :0 x094C | C0E0 | PUSH | 0 xE0
C :0 x094E | C0F0 | PUSH | 0 xF0
C :0 x0950 | C0D0 | PUSH | 0 xD0
C :0 x0952 | 75 D000 | MOV | 0 xD0 ,#0 x00
C :0 x0955 | C000 | PUSH | 0 x00
C :0 x0957 | C004 | PUSH | 0 x04
C :0 x0959 | C005 | PUSH | 0 x05
C :0 x095B | C006 | PUSH | 0 x06
C :0 x095D | C007 | PUSH | 0 x07
344: | TEST1 = 1;
345:
346:
C :0 x095F | D294 | SETB | TEST1 (0 x90 .4)
347: | adc1 = readAdc ( ADC1 );
C :0 x0961 | 7 F08 | MOV | R7 ,#0 x08
C :0 x0963 | 120 B7B | LCALL | readAdc (C :0 B7B )
C :0 x0966 | 8 E2A | MOV | adc1 (0 x2A ), R6
C :0 x0968 | 8 F2B | MOV | 0 x2B , R7
348: | adc2 = readAdc ( ADC2 );
C :0 x096A | 7 F09 | MOV | R7 ,#0 x09
C :0 x096C | 120 B7B | LCALL | readAdc (C :0 B7B )
C :0 x096F | 8 E2C | MOV | adc2 (0 x2C ), R6
C :0 x0971 | 8 F2D | MOV | 0 x2D , R7
349: | adc3 = readAdc ( ADC3 );
C :0 x0973 | 7 F0A | MOV | R7 ,#0 x0A
C :0 x0975 | 120 B7B | LCALL | readAdc (C :0 B7B )
C :0 x0978 | 8 E30 | MOV | adc3 (0 x30 ), R6
C :0 x097A | 8 F31 | MOV | 0 x31 , R7
350: | current = ( adc2 - adc3 )*10;

351:
C :0 x097C | C3 | CLR | C
C :0 x097D | E52D | MOV | A ,0 x2D
C :0 x097F | 9531 | SUBB | A ,0 x31
C :0 x0981 | FF | MOV | R7 ,A
C :0 x0982 | E52C | MOV | A , adc2 (0 x2C )
C :0 x0984 | 9530 | SUBB | A , adc3 (0 x30 )
C :0 x0986 | FE | MOV | R6 ,A
C :0 x0987 | 7 C00 | MOV | R4 ,#0 x00
C :0 x0989 | 7 D0A | MOV | R5 ,#0 x0A
C :0 x098B | 120 A2C | LCALL | C? IMUL (C :0 A2C )
C :0 x098E | 8 E21 | MOV | current (0 x21 ) , R6
C :0 x0990 | 8 F22 | MOV | 0 x22 , R7
352: | if (( adc1 < low_mV ) || ( adc1 > high_mV )){ | // Watch input voltage
C :0 x0992 | C3 | CLR | C
C :0 x0993 | E52B | MOV | A ,0 x2B
C :0 x0995 | 9538 | SUBB | A ,0 x38
C :0 x0997 | E52A | MOV | A , adc1 (0 x2A )
C :0 x0999 | 9537 | SUBB | A , low_mV (0 x37 )
C :0 x099B | 400 B | JC | C :09 A8
C :0 x099D | D3 | SETB | C
C :0 x099E | E52B | MOV | A ,0 x2B
C :0 x09A0 | 9528 | SUBB | A ,0 x28
C :0 x09A2 | E52A | MOV | A , adc1 (0 x2A )
C :0 x09A4 | 9527 | SUBB | A , high_mV (0 x27 )
C :0 x09A6 | 4002 | JC | C :09 AA
353: | enabled = false ;
C :0 x09A8 | C202 | CLR | enabled (0 x20 .2)
354: | }
355:
356:
357: | error = ( int ) target_mV - ( int ) adc3 ; | // PID controller
C :0 x09AA | AE30 | MOV | R6 , adc3 (0 x30 )
C :0 x09AC | AF31 | MOV | R7 ,0 x31
C :0 x09AE | AC25 | MOV | R4 , target_mV (0 x25 )
C :0 x09B0 | AD26 | MOV | R5 ,0 x26
C :0 x09B2 | C3 | CLR | C
C :0 x09B3 | ED | MOV | A , R5
C :0 x09B4 | 9F | SUBB | A , R7
C :0 x09B5 | FF | MOV | R7 ,A
C :0 x09B6 | EC | MOV | A , R4
C :0 x09B7 | 9E | SUBB | A , R6
C :0 x09B8 | FE | MOV | R6 ,A
358: | integral += error ;
C :0 x09B9 | EF | MOV | A , R7
C :0 x09BA | 252 F | ADD | A ,0 x2F
C :0 x09BC | F52F | MOV | 0 x2F ,A
C :0 x09BE | EE | MOV | A , R6
C :0 x09BF | 352 E | ADDC | A , integral (0 x2E )
C :0 x09C1 | F52E | MOV | integral (0 x2E ),A
359: | out = (( error *P) + ( integral *I )) >> 10; | // Divide by 1024
C :0 x09C3 | 7 C00 | MOV | R4 ,#0 x00
C :0 x09C5 | 7 D05 | MOV | R5 ,#0 x05
C :0 x09C7 | 120 A2C | LCALL | C? IMUL (C :0 A2C )
C :0 x09CA | AC06 | MOV | R4 ,0 x06
C :0 x09CC | AD07 | MOV | R5 ,0 x07
C :0 x09CE | E52F | MOV | A ,0 x2F
C :0 x09D0 | 25 E0 | ADD | A ,0 xE0
C :0 x09D2 | FF | MOV | R7 ,A
C :0 x09D3 | E52E | MOV | A , integral (0 x2E )
C :0 x09D5 | 33 | RLC | A
C :0 x09D6 | FE | MOV | R6 ,A
C :0 x09D7 | ED | MOV | A , R5
C :0 x09D8 | 2F | ADD | A , R7
C :0 x09D9 | FF | MOV | R7 ,A
C :0 x09DA | EC | MOV | A , R4
C :0 x09DB | 3E | ADDC | A , R6
C :0 x09DC | FE | MOV | R6 ,A
C :0 x09DD | EF | MOV | A , R7
C :0 x09DE | 780 A | MOV | R0 ,#0 x0A
C :0 x09E0 | CE | XCH | A , R6
C :0 x09E1 | A2E7 | MOV | C ,0 xE0 .7
C :0 x09E3 | 13 | RRC | A
C :0 x09E4 | CE | XCH | A , R6
C :0 x09E5 | 13 | RRC | A
C :0 x09E6 | D8F8 | DJNZ | R0 ,C :09 E0
C :0 x09E8 | FF | MOV | R7 ,A
360: | if (( out < 0) || (! enabled )){
C :0 x09E9 | C3 | CLR | C
C :0 x09EA | EE | MOV | A , R6
C :0 x09EB | 6480 | XRL | A ,#0 x80
C :0 x09ED | 9480 | SUBB | A ,#0 x80
C :0 x09EF | 4003 | JC | C :09 F4
C :0 x09F1 | 200202 | JB | enabled (0 x20 .2) , C :09 F6
361: | out = 0;
C :0 x09F4 | 7 F00 | MOV | R7 ,#0 x00
362: | }
363: | duty = out ;
C :0 x09F6 | 8 F29 | MOV | duty (0 x29 ), R7
364: | PCA0CPH0 = PCA0CPH1 = 0 xFF - out ;
365:
366:
367:
C :0 x09F8 | C3 | CLR | C
C :0 x09F9 | 74 FF | MOV | A ,#0 xFF
C :0 x09FB | 9F | SUBB | A , R7
C :0 x09FC | F5EA | MOV | PCA0CPH1 (0 xEA ),A
C :0 x09FE | F5FC | MOV | PCA0CPH0 (0 xFC ),A
368: | if ( head != tail ){

C :0 x0A00 | E523 | MOV | A , head (0 x23 )
C :0 x0A02 | 6524 | XRL | A , tail (0 x24 )
C :0 x0A04 | 600 E | JZ | C :0 A14
369: | SBUF0 = uart_out [ tail ]; | // Timer tuned so no need to check
C :0 x0A06 | AF24 | MOV | R7 , tail (0 x24 )
C :0 x0A08 | 7439 | MOV | A ,# uart_out (0 x39 )
C :0 x0A0A | 2F | ADD | A , R7
C :0 x0A0B | F8 | MOV | R0 ,A
C :0 x0A0C | E6 | MOV | A , @R0
C :0 x0A0D | F599 | MOV | SBUF0 (0 x99 ),A
370: | tail ++; | // Transmit UART
C :0 x0A0F | 0524 | INC | tail (0 x24 )
371: | tail %= UART_SIZE_OUT ; | // Wrap around
C :0 x0A11 | 532407 | ANL | tail (0 x24 ) ,#0 x07
372: | }
373:
374:
375: | TMR2H = 255; | // Runs at 4 KHz
C :0 x0A14 | 75 CDFF | MOV | TMR2H (0 xCD ) ,#0 xFF
376: | TMR2CN_TF2H = 0;
// Enable interrupt again
C :0 x0A17 | C2CF | CLR | TMR2CN_TF2H (0 xC8 .7)
377: | TEST1 = 0;
// Timing debug
C :0 x0A19 | C294 | CLR | TEST1 (0 x90 .4)
378: }
C :0 x0A1B | D007 | POP | 0 x07
C :0 x0A1D | D006 | POP | 0 x06
C :0 x0A1F | D005 | POP | 0 x05
C :0 x0A21 | D004 | POP | 0 x04
C :0 x0A23 | D000 | POP | 0 x00
C :0 x0A25 | D0D0 | POP | 0 xD0
C :0 x0A27 | D0F0 | POP | 0 xF0
C :0 x0A29 | D0E0 | POP | 0 xE0
C :0 x0A2B | 32 | RETI
C? IMUL :
C :0 x0A2C | EF | MOV | A , R7
C :0 x0A2D | 8 DF0 | MOV | 0 xF0 , R5
C :0 x0A2F | A4 | MUL | AB
C :0 x0A30 | A8F0 | MOV | R0 ,0 xF0
C :0 x0A32 | CF | XCH | A , R7
C :0 x0A33 | 8 CF0 | MOV | 0 xF0 , R4
C :0 x0A35 | A4 | MUL | AB
C :0 x0A36 | 28 | ADD | A , R0
C :0 x0A37 | CE | XCH | A , R6
C :0 x0A38 | 8 DF0 | MOV | 0 xF0 , R5
C :0 x0A3A | A4 | MUL | AB
C :0 x0A3B | 2E | ADD | A , R6
C :0 x0A3C | FE | MOV | R6 ,A
C :0 x0A3D | 22 | RET
C? UIDIV :
C :0 x0A3E | BC000B | CJNE | R4 ,#0 x00 ,C :0 A4C
C :0 x0A41 | BE0029 | CJNE | R6 ,#0 x00 ,C :0 A6D
C :0 x0A44 | EF | MOV | A , R7
C :0 x0A45 | 8 DF0 | MOV | 0 xF0 , R5
C :0 x0A47 | 84 | DIV | AB
C :0 x0A48 | FF | MOV | R7 ,A
C :0 x0A49 | ADF0 | MOV | R5 ,0 xF0
C :0 x0A4B | 22 | RET
C :0 x0A4C | E4 | CLR | A
C :0 x0A4D | CC | XCH | A , R4
C :0 x0A4E | F8 | MOV | R0 ,A
C :0 x0A4F | 75 F008 | MOV | 0 xF0 ,#0 x08
C :0 x0A52 | EF | MOV | A , R7
C :0 x0A53 | 2F | ADD | A , R7
C :0 x0A54 | FF | MOV | R7 ,A
C :0 x0A55 | EE | MOV | A , R6
C :0 x0A56 | 33 | RLC | A
C :0 x0A57 | FE | MOV | R6 ,A
C :0 x0A58 | EC | MOV | A , R4
C :0 x0A59 | 33 | RLC | A
C :0 x0A5A | FC | MOV | R4 ,A
C :0 x0A5B | EE | MOV | A , R6
C :0 x0A5C | 9D | SUBB | A , R5
C :0 x0A5D | EC | MOV | A , R4
C :0 x0A5E | 98 | SUBB | A , R0
C :0 x0A5F | 4005 | JC | C :0 A66
C :0 x0A61 | FC | MOV | R4 ,A
C :0 x0A62 | EE | MOV | A , R6
C :0 x0A63 | 9D | SUBB | A , R5
C :0 x0A64 | FE | MOV | R6 ,A
C :0 x0A65 | 0F | INC | R7
C :0 x0A66 | D5F0E9 | DJNZ | 0 xF0 ,C :0 A52
C :0 x0A69 | E4 | CLR | A
C :0 x0A6A | CE | XCH | A , R6
C :0 x0A6B | FD | MOV | R5 ,A
C :0 x0A6C | 22 | RET
C :0 x0A6D | ED | MOV | A , R5
C :0 x0A6E | F8 | MOV | R0 ,A
C :0 x0A6F | F5F0 | MOV | 0 xF0 ,A
C :0 x0A71 | EE | MOV | A , R6
C :0 x0A72 | 84 | DIV | AB
C :0 x0A73 | 20 D21C | JB | 0 xD0 .2 , C :0 A92
C :0 x0A76 | FE | MOV | R6 ,A
C :0 x0A77 | ADF0 | MOV | R5 ,0 xF0
C :0 x0A79 | 75 F008 | MOV | 0 xF0 ,#0 x08
C :0 x0A7C | EF | MOV | A , R7
C :0 x0A7D | 2F | ADD | A , R7
C :0 x0A7E | FF | MOV | R7 ,A

C :0 x0A7F | ED | MOV | A , R5
C :0 x0A80 | 33 | RLC | A
C :0 x0A81 | FD | MOV | R5 ,A
C :0 x0A82 | 4007 | JC | C :0 A8B
C :0 x0A84 | 98 | SUBB | A , R0
C :0 x0A85 | 5006 | JNC | C :0 A8D
C :0 x0A87 | D5F0F2 | DJNZ | 0 xF0 ,C :0 A7C
C :0 x0A8A | 22 | RET
C :0 x0A8B | C3 | CLR | C
C :0 x0A8C | 98 | SUBB | A , R0
C :0 x0A8D | FD | MOV | R5 ,A
C :0 x0A8E | 0F | INC | R7
C :0 x0A8F | D5F0EA | DJNZ | 0 xF0 ,C :0 A7C
C :0 x0A92 | 22 | RET
C? ULSHR :
C :0 x0A93 | E8 | MOV | A , R0
C :0 x0A94 | 600 F | JZ | C :0 AA5
C :0 x0A96 | EC | MOV | A , R4
C :0 x0A97 | C3 | CLR | C
C :0 x0A98 | 13 | RRC | A
C :0 x0A99 | FC | MOV | R4 ,A
C :0 x0A9A | ED | MOV | A , R5
C :0 x0A9B | 13 | RRC | A
C :0 x0A9C | FD | MOV | R5 ,A
C :0 x0A9D | EE | MOV | A , R6
C :0 x0A9E | 13 | RRC | A
C :0 x0A9F | FE | MOV | R6 ,A
C :0 x0AA0 | EF | MOV | A , R7
C :0 x0AA1 | 13 | RRC | A
C :0 x0AA2 | FF | MOV | R7 ,A
C :0 x0AA3 | D8F1 | DJNZ | R0 ,C :0 A96
C :0 x0AA5 | 22 | RET
C? CCASE :
C :0 x0AA6 | D083 | POP | 0 x83
C :0 x0AA8 | D082 | POP | 0 x82
C :0 x0AAA | F8 | MOV | R0 ,A
C :0 x0AAB | E4 | CLR | A
C :0 x0AAC | 93 | MOVC | A , @A + DPTR
C :0 x0AAD | 7012 | JNZ | C :0 AC1
C :0 x0AAF | 7401 | MOV | A ,#0 x01
C :0 x0AB1 | 93 | MOVC | A , @A + DPTR
C :0 x0AB2 | 700 D | JNZ | C :0 AC1
C :0 x0AB4 | A3 | INC | DPTR
C :0 x0AB5 | A3 | INC | DPTR
C :0 x0AB6 | 93 | MOVC | A , @A + DPTR
C :0 x0AB7 | F8 | MOV | R0 ,A
C :0 x0AB8 | 7401 | MOV | A ,#0 x01
C :0 x0ABA | 93 | MOVC | A , @A + DPTR
C :0 x0ABB | F582 | MOV | 0 x82 ,A
C :0 x0ABD | 8883 | MOV | 0 x83 , R0
C :0 x0ABF | E4 | CLR | A
C :0 x0AC0 | 73 | JMP | @A + DPTR
C :0 x0AC1 | 7402 | MOV | A ,#0 x02
C :0 x0AC3 | 93 | MOVC | A , @A + DPTR
C :0 x0AC4 | 68 | XRL | A , R0
C :0 x0AC5 | 60 EF | JZ | C :0 AB6
C :0 x0AC7 | A3 | INC | DPTR
C :0 x0AC8 | A3 | INC | DPTR
C :0 x0AC9 | A3 | INC | DPTR
C :0 x0ACA | 80 DF | SJMP | C :0 AAB
C? LIMUL :
C :0 x0ACC | EC | MOV | A , R4
C :0 x0ACD | 8 EF0 | MOV | 0 xF0 , R6
C :0 x0ACF | A4 | MUL | AB
C :0 x0AD0 | CC | XCH | A , R4
C :0 x0AD1 | C5F0 | XCH | A ,0 xF0
C :0 x0AD3 | CC | XCH | A , R4
C :0 x0AD4 | CD | XCH | A , R5
C :0 x0AD5 | F8 | MOV | R0 ,A
C :0 x0AD6 | EF | MOV | A , R7
C :0 x0AD7 | A4 | MUL | AB
C :0 x0AD8 | CE | XCH | A , R6
C :0 x0AD9 | C5F0 | XCH | A ,0 xF0
C :0 x0ADB | 2D | ADD | A , R5
C :0 x0ADC | FD | MOV | R5 ,A
C :0 x0ADD | E4 | CLR | A
C :0 x0ADE | 3C | ADDC | A , R4
C :0 x0ADF | FC | MOV | R4 ,A
C :0 x0AE0 | E8 | MOV | A , R0
C :0 x0AE1 | A4 | MUL | AB
C :0 x0AE2 | 2E | ADD | A , R6
C :0 x0AE3 | C8 | XCH | A , R0
C :0 x0AE4 | C5F0 | XCH | A ,0 xF0
C :0 x0AE6 | 3D | ADDC | A , R5
C :0 x0AE7 | FD | MOV | R5 ,A
C :0 x0AE8 | E4 | CLR | A
C :0 x0AE9 | 3C | ADDC | A , R4
C :0 x0AEA | FC | MOV | R4 ,A
C :0 x0AEB | EF | MOV | A , R7
C :0 x0AEC | A4 | MUL | AB
C :0 x0AED | FF | MOV | R7 ,A
C :0 x0AEE | E5F0 | MOV | A ,0 xF0
C :0 x0AF0 | 28 | ADD | A , R0
C :0 x0AF1 | FE | MOV | R6 ,A
C :0 x0AF2 | E4 | CLR | A
C :0 x0AF3 | 3D | ADDC | A , R5
C :0 x0AF4 | FD | MOV | R5 ,A
C :0 x0AF5 | E4 | CLR | A
C :0 x0AF6 | 3C | ADDC | A , R4

C :0 x0AF7 | FC | MOV | R4 ,A
C :0 x0AF8 | 22 | RET
296: U16 uartNumbers ( U16 toSend , bool transmit ){ | // Tx / Rx up to 4 length numbers over UART
297: | U16 out = toSend ;
C :0 x0AF9 | 8 E08 | MOV | 0 x08 , R6
C :0 x0AFB | 8 F09 | MOV | 0 x09 , R7
298: | U16 num = 0;
C :0 x0AFD | E4 | CLR | A
C :0 x0AFE | FB | MOV | R3 ,A
C :0 x0AFF | FA | MOV | R2 ,A
299: | U16 scale = 10000;
300: | U8 test ;
C :0 x0B00 | 902710 | MOV | DPTR ,#0 x2710
301: | U8 i = 4;
C :0 x0B03 | 750 B04 | MOV | 0 x0B ,#0 x04
302: | bool bad = false ;
C :0 x0B06 | C201 | CLR | 0 x20 .1
303: | while (i ){
// On zero done
C :0 x0B08 | E50B | MOV | A ,0 x0B
C :0 x0B0A | 6059 | JZ | C :0 B65
304: | scale /= 10; | // Shift
C :0 x0B0C | 7 C00 | MOV | R4 ,#0 x00
C :0 x0B0E | 7 D0A | MOV | R5 ,#0 x0A
C :0 x0B10 | AF82 | MOV | R7 ,0 x82
C :0 x0B12 | AE83 | MOV | R6 ,0 x83
C :0 x0B14 | 120 A3E | LCALL | C? UIDIV (C :0 A3E )
C :0 x0B17 | 8 E83 | MOV | 0 x83 , R6
C :0 x0B19 | 8 F82 | MOV | 0 x82 , R7
305: | i - -; | // Move through UART array
C :0 x0B1B | 150 B | DEC | 0 x0B
306: | test = uart_in [ i] - 48; | // ascii to num
C :0 x0B1D | 7432 | MOV | A ,# uart_in (0 x32 )
C :0 x0B1F | 250 B | ADD | A ,0 x0B
C :0 x0B21 | F8 | MOV | R0 ,A
C :0 x0B22 | E6 | MOV | A , @R0
C :0 x0B23 | 24 D0 | ADD | A ,#0 xD0
C :0 x0B25 | F50A | MOV | 0 x0A ,A
307: | if ( test > 10){ | // check is 0 to 9, unsigned
C :0 x0B27 | D3 | SETB | C
C :0 x0B28 | 940 A | SUBB | A ,#0 x0A
C :0 x0B2A | 4002 | JC | C :0 B2E
308: | | | bad = true ;
C :0 x0B2C | D201 | SETB | 0 x20 .1
309: | | }
310: | num += test * scale ;
// shift in to position
C :0 x0B2E | AF0A | MOV | R7 ,0 x0A
C :0 x0B30 | 7 E00 | MOV | R6 ,#0 x00
C :0 x0B32 | AD82 | MOV | R5 ,0 x82
C :0 x0B34 | AC83 | MOV | R4 ,0 x83
C :0 x0B36 | 120 A2C | LCALL | C? IMUL (C :0 A2C )
C :0 x0B39 | EF | MOV | A , R7
C :0 x0B3A | 2B | ADD | A , R3
C :0 x0B3B | FB | MOV | R3 ,A
C :0 x0B3C | EE | MOV | A , R6
C :0 x0B3D | 3A | ADDC | A , R2
C :0 x0B3E | FA | MOV | R2 ,A
311: | if ( transmit ){ | // Put if statement at back of loop to save on jumps
C :0 x0B3F | 3000 C6 | JNB | 0 x20 .0 , C :0 B08
312: | | | num = out / scale ;
// 10 powers
C :0 x0B42 | AE08 | MOV | R6 ,0 x08
C :0 x0B44 | AF09 | MOV | R7 ,0 x09
C :0 x0B46 | 120 A3E | LCALL | C? UIDIV (C :0 A3E )
C :0 x0B49 | AA06 | MOV | R2 ,0 x06
C :0 x0B4B | AB07 | MOV | R3 ,0 x07
313: | uartLoadOut ( num + 48); | // Number to ascii
C :0 x0B4D | EF | MOV | A , R7
C :0 x0B4E | 2430 | ADD | A ,# adc3 (0 x30 )
C :0 x0B50 | FF | MOV | R7 ,A
C :0 x0B51 | 120 B9C | LCALL | uartLoadOut (C :0 B9C )
314: | out %= scale ; | // Remainder for next time
C :0 x0B54 | AE08 | MOV | R6 ,0 x08
C :0 x0B56 | AF09 | MOV | R7 ,0 x09
C :0 x0B58 | AD82 | MOV | R5 ,0 x82
C :0 x0B5A | AC83 | MOV | R4 ,0 x83
C :0 x0B5C | 120 A3E | LCALL | C? UIDIV (C :0 A3E )
C :0 x0B5F | 8 C08 | MOV | 0 x08 , R4
C :0 x0B61 | 8 D09 | MOV | 0 x09 , R5
315: | | }
316: | }
C :0 x0B63 | 80 A3 | SJMP | C :0 B08
317: | uartLoadOut ( ’\n ’);
C :0 x0B65 | 7 F0A | MOV | R7 ,#0 x0A
C :0 x0B67 | 120 B9C | LCALL | uartLoadOut (C :0 B9C )
318: | uartLoadOut ( ’\r ’);
C :0 x0B6A | 7 F0D | MOV | R7 ,#0 x0D
C :0 x0B6C | 120 B9C | LCALL | uartLoadOut (C :0 B9C )
319: | if ( bad ){
C :0 x0B6F | 300104 | JNB | 0 x20 .1 , C :0 B76
320: | num = DEFAULT_OUT_MV ; | // Not all valid numbers so set output as default
C :0 x0B72 | 7 A13 | MOV | R2 ,#0 x13
C :0 x0B74 | 7 B88 | MOV | R3 ,# TCON (0 x88 )
321: | }
322: | return num ;
C :0 x0B76 | AE02 | MOV | R6 ,0 x02
C :0 x0B78 | AF03 | MOV | R7 ,0 x03
323: }

324:
C :0 x0B7A | 22 | RET
325: U16 readAdc ( U8 sel ){ | // Read the available ADCs
326: | U8 i;
327: | ADC0MX = sel ;
C :0 x0B7B | 8 FBB | MOV | ADC0MX (0 xBB ), R7
328: | for ( i =0; i <2; i ++){
C :0 x0B7D | E4 | CLR | A
C :0 x0B7E | FF | MOV | R7 ,A
329: | ADC0CN0 |= ADC0CN0_ADBUSY__SET ;
C :0 x0B7F | 43 E810 | ORL | ADC0CN0 (0 xE8 ) ,#0 x10
330: | while ( ADC0CN0 & ADC0CN0_ADBUSY__SET ); | // Wait for sample to complete
C :0 x0B82 | E5E8 | MOV | A , ADC0CN0 (0 xE8 )
C :0 x0B84 | 20 E4FB | JB | 0 xE0 .4 , C :0 B82
331: | }
C :0 x0B87 | 0F | INC | R7
C :0 x0B88 | BF02F4 | CJNE | R7 ,#0 x02 ,C :0 B7F
332: | return ((( U32 ) ADC0 )* SCALE_MUL ) >> 10; | // Scale to mV
C :0 x0B8B | AFBD | MOV | R7 , ADC0 (0 xBD )
C :0 x0B8D | AEBE | MOV | R6 ,0 xBE
C :0 x0B8F | 7 C17 | MOV | R4 ,#0 x17
C :0 x0B91 | 7 DB4 | MOV | R5 ,#0 xB4
C :0 x0B93 | 120 ACC | LCALL | C? LIMUL (C :0 ACC )
C :0 x0B96 | 780 A | MOV | R0 ,#0 x0A
C :0 x0B98 | 120 A93 | LCALL | C? ULSHR (C :0 A93 )
333: }
334:
335: // - - - - - - -- - - - - - - - -- - - - - - - - -- - - - - - - - -- - - - - - - - -- - - - - - - - -- - - - - - - - -- - - - - - - - -- - - - - - -336: // Interrupt Routines
337: // - - - - - - -- - - - - - - - -- - - - - - - - -- - - - - - - - -- - - - - - - - -- - - - - - - - -- - - - - - - - -- - - - - - - - -- - - - - - -338:
C :0 x0B9B | 22 | RET
290: void uartLoadOut ( U8 tx ){
// Handle buffering out Tx UART
291: | uart_out [ head ] = tx ; | // Buffer outgoing
C :0 x0B9C | AE23 | MOV | R6 , head (0 x23 )
C :0 x0B9E | 7439 | MOV | A ,# uart_out (0 x39 )
C :0 x0BA0 | 2E | ADD | A , R6
C :0 x0BA1 | F8 | MOV | R0 ,A
C :0 x0BA2 | A607 | MOV | @R0 ,0 x07
292: | head ++;
C :0 x0BA4 | 0523 | INC | head (0 x23 )
293: | head %= UART_SIZE_OUT ; | // Wrap around
C :0 x0BA6 | 532307 | ANL | head (0 x23 ) ,#0 x07
294: }
C :0 x0BA9 | 22 | RET
C :0 x0BAA | 787 F | MOV | R0 ,#0 x7F
C :0 x0BAC | E4 | CLR | A
C :0 x0BAD | F6 | MOV | @R0 ,A
C :0 x0BAE | D8FD | DJNZ | R0 ,C :0 BAD
C :0 x0BB0 | 758140 | MOV | 0 x81 ,#0 x40
C :0 x0BB3 | 020800 | LJMP | main (C :0800)
339: INTERRUPT ( TIMER1_ISR , TIMER1_IRQn ){} | // Needed for UART timing
C :0 x0BB6 | 32 | RETI

# Listing 5: LIMUL

C? LIMUL :
C :0 x0ACC | EC | MOV | A , R4
C :0 x0ACD | 8 EF0 | MOV | 0 xF0 , R6
C :0 x0ACF | A4 | MUL | AB
C :0 x0AD0 | CC | XCH | A , R4
C :0 x0AD1 | C5F0 | XCH | A ,0 xF0
C :0 x0AD3 | CC | XCH | A , R4
C :0 x0AD4 | CD | XCH | A , R5
C :0 x0AD5 | F8 | MOV | R0 ,A
C :0 x0AD6 | EF | MOV | A , R7
C :0 x0AD7 | A4 | MUL | AB
C :0 x0AD8 | CE | XCH | A , R6
C :0 x0AD9 | C5F0 | XCH | A ,0 xF0
C :0 x0ADB | 2D | ADD | A , R5
C :0 x0ADC | FD | MOV | R5 ,A
C :0 x0ADD | E4 | CLR | A
C :0 x0ADE | 3C | ADDC | A , R4
C :0 x0ADF | FC | MOV | R4 ,A
C :0 x0AE0 | E8 | MOV | A , R0
C :0 x0AE1 | A4 | MUL | AB
C :0 x0AE2 | 2E | ADD | A , R6
C :0 x0AE3 | C8 | XCH | A , R0
C :0 x0AE4 | C5F0 | XCH | A ,0 xF0
C :0 x0AE6 | 3D | ADDC | A , R5
C :0 x0AE7 | FD | MOV | R5 ,A
C :0 x0AE8 | E4 | CLR | A
C :0 x0AE9 | 3C | ADDC | A , R4
C :0 x0AEA | FC | MOV | R4 ,A
C :0 x0AEB | EF | MOV | A , R7
C :0 x0AEC | A4 | MUL | AB
C :0 x0AED | FF | MOV | R7 ,A
C :0 x0AEE | E5F0 | MOV | A ,0 xF0
C :0 x0AF0 | 28 | ADD | A , R0
C :0 x0AF1 | FE | MOV | R6 ,A
C :0 x0AF2 | E4 | CLR | A
C :0 x0AF3 | 3D | ADDC | A , R5
C :0 x0AF4 | FD | MOV | R5 ,A
C :0 x0AF5 | E4 | CLR | A
C :0 x0AF6 | 3C | ADDC | A , R4
C :0 x0AF7 | FC | MOV | R4 ,A

C :0 x0AF8 | 22 | RET

# Listing 6: ULSHR

| C? ULSHR :
C :0 x0A93 | E8 | MOV | A , R0
C :0 x0A94 | 600 F | JZ | C :0 AA5
C :0 x0A96 | EC | MOV | A , R4
C :0 x0A97 | C3 | CLR | C
C :0 x0A98 | 13 | RRC | A
C :0 x0A99 | FC | MOV | R4 ,A
C :0 x0A9A | ED | MOV | A , R5
C :0 x0A9B | 13 | RRC | A
C :0 x0A9C | FD | MOV | R5 ,A
C :0 x0A9D | EE | MOV | A , R6
C :0 x0A9E | 13 | RRC | A
C :0 x0A9F | FE | MOV | R6 ,A
C :0 x0AA0 | EF | MOV | A , R7
C :0 x0AA1 | 13 | RRC | A
C :0 x0AA2 | FF | MOV | R7 ,A
C :0 x0AA3 | D8F1 | DJNZ | R0 ,C :0 A96
C :0 x0AA5 | 22 | RET

# Listing 7: IMUL

C? IMUL :
C :0 x0A2C | EF | MOV | A , R7
C :0 x0A2D | 8 DF0 | MOV | 0 xF0 , R5
C :0 x0A2F | A4 | MUL | AB
C :0 x0A30 | A8F0 | MOV | R0 ,0 xF0
C :0 x0A32 | CF | XCH | A , R7
C :0 x0A33 | 8 CF0 | MOV | 0 xF0 , R4
C :0 x0A35 | A4 | MUL | AB
C :0 x0A36 | 28 | ADD | A , R0
C :0 x0A37 | CE | XCH | A , R6
C :0 x0A38 | 8 DF0 | MOV | 0 xF0 , R5
C :0 x0A3A | A4 | MUL | AB
C :0 x0A3B | 2E | ADD | A , R6
C :0 x0A3C | FE | MOV | R6 ,A
C :0 x0A3D | 22 | RET

# Listing 8: UDIV

C? UIDIV :
C :0 x0A3E | BC000B | CJNE | R4 ,#0 x00 ,C :0 A4C
C :0 x0A41 | BE0029 | CJNE | R6 ,#0 x00 ,C :0 A6D
C :0 x0A44 | EF | MOV | A , R7
C :0 x0A45 | 8 DF0 | MOV | 0 xF0 , R5
C :0 x0A47 | 84 | DIV | AB
C :0 x0A48 | FF | MOV | R7 ,A
C :0 x0A49 | ADF0 | MOV | R5 ,0 xF0
C :0 x0A4B | 22 | RET
C :0 x0A4C | E4 | CLR | A
C :0 x0A4D | CC | XCH | A , R4
C :0 x0A4E | F8 | MOV | R0 ,A
C :0 x0A4F | 75 F008 | MOV | 0 xF0 ,#0 x08
C :0 x0A52 | EF | MOV | A , R7
C :0 x0A53 | 2F | ADD | A , R7
C :0 x0A54 | FF | MOV | R7 ,A
C :0 x0A55 | EE | MOV | A , R6
C :0 x0A56 | 33 | RLC | A
C :0 x0A57 | FE | MOV | R6 ,A
C :0 x0A58 | EC | MOV | A , R4
C :0 x0A59 | 33 | RLC | A
C :0 x0A5A | FC | MOV | R4 ,A
C :0 x0A5B | EE | MOV | A , R6
C :0 x0A5C | 9D | SUBB | A , R5
C :0 x0A5D | EC | MOV | A , R4
C :0 x0A5E | 98 | SUBB | A , R0
C :0 x0A5F | 4005 | JC | C :0 A66
C :0 x0A61 | FC | MOV | R4 ,A
C :0 x0A62 | EE | MOV | A , R6
C :0 x0A63 | 9D | SUBB | A , R5
C :0 x0A64 | FE | MOV | R6 ,A
C :0 x0A65 | 0F | INC | R7
C :0 x0A66 | D5F0E9 | DJNZ | 0 xF0 ,C :0 A52
C :0 x0A69 | E4 | CLR | A
C :0 x0A6A | CE | XCH | A , R6
C :0 x0A6B | FD | MOV | R5 ,A
C :0 x0A6C | 22 | RET
C :0 x0A6D | ED | MOV | A , R5
C :0 x0A6E | F8 | MOV | R0 ,A
C :0 x0A6F | F5F0 | MOV | 0 xF0 ,A
C :0 x0A71 | EE | MOV | A , R6
C :0 x0A72 | 84 | DIV | AB
C :0 x0A73 | 20 D21C | JB | 0 xD0 .2 , C :0 A92
C :0 x0A76 | FE | MOV | R6 ,A
C :0 x0A77 | ADF0 | MOV | R5 ,0 xF0
C :0 x0A79 | 75 F008 | MOV | 0 xF0 ,#0 x08
C :0 x0A7C | EF | MOV | A , R7
C :0 x0A7D | 2F | ADD | A , R7
C :0 x0A7E | FF | MOV | R7 ,A
C :0 x0A7F | ED | MOV | A , R5

C :0 x0A80 | 33 | RLC | A
C :0 x0A81 | FD | MOV | R5 ,A
C :0 x0A82 | 4007 | JC | C :0 A8B
C :0 x0A84 | 98 | SUBB | A , R0
C :0 x0A85 | 5006 | JNC | C :0 A8D
C :0 x0A87 | D5F0F2 | DJNZ | 0 xF0 ,C :0 A7C
C :0 x0A8A | 22 | RET
C :0 x0A8B | C3 | CLR | C
C :0 x0A8C | 98 | SUBB | A , R0
C :0 x0A8D | FD | MOV | R5 ,A
C :0 x0A8E | 0F | INC | R7
C :0 x0A8F | D5F0EA | DJNZ | 0 xF0 ,C :0 A7C
C :0 x0A92 | 22 | RET

# Listing 9: CCASE

C? CCASE :
C :0 x0AA6 | D083 | POP | 0 x83
C :0 x0AA8 | D082 | POP | 0 x82
C :0 x0AAA | F8 | MOV | R0 ,A
C :0 x0AAB | E4 | CLR | A
C :0 x0AAC | 93 | MOVC | A , @A + DPTR
C :0 x0AAD | 7012 | JNZ | C :0 AC1
C :0 x0AAF | 7401 | MOV | A ,#0 x01
C :0 x0AB1 | 93 | MOVC | A , @A + DPTR
C :0 x0AB2 | 700 D | JNZ | C :0 AC1
C :0 x0AB4 | A3 | INC | DPTR
C :0 x0AB5 | A3 | INC | DPTR
C :0 x0AB6 | 93 | MOVC | A , @A + DPTR
C :0 x0AB7 | F8 | MOV | R0 ,A
C :0 x0AB8 | 7401 | MOV | A ,#0 x01
C :0 x0ABA | 93 | MOVC | A , @A + DPTR
C :0 x0ABB | F582 | MOV | 0 x82 ,A
C :0 x0ABD | 8883 | MOV | 0 x83 , R0
C :0 x0ABF | E4 | CLR | A
C :0 x0AC0 | 73 | JMP | @A + DPTR
C :0 x0AC1 | 7402 | MOV | A ,#0 x02
C :0 x0AC3 | 93 | MOVC | A , @A + DPTR
C :0 x0AC4 | 68 | XRL | A , R0
C :0 x0AC5 | 60 EF | JZ | C :0 AB6
C :0 x0AC7 | A3 | INC | DPTR
C :0 x0AC8 | A3 | INC | DPTR
C :0 x0AC9 | A3 | INC | DPTR
C :0 x0ACA | 80 DF | SJMP | C :0 AAB
