ashleyjr/Switcher/(threads)

Thread 2 (2016-11-30):

Build circuit on stripboard

ashleyjr, 2016-11-30:

ashleyjr, 2016-12-06:
Need to add switcher section.

ashleyjr, 2016-12-14:
Done but opened #14  to fix issue

Closed 2016-12-14.

Thread 3 (2016-11-30):

Working UART

ashleyjr, 2016-11-30:

ashleyjr, 2016-12-02:
UART RX does not work

ashleyjr, 2016-12-03:
Custom blocking routines working for UART

Closed 2016-12-03.

Thread 4 (2016-11-30):

Working PWM

ashleyjr, 2016-11-30:

ashleyjr, 2016-12-02:
Much too slow!

Closed 2016-12-03.

Thread 7 (2016-12-03):

UART ISR

ashleyjr, 2016-12-03:

ashleyjr, 2016-12-06:
May not be needed? Might just use single byte commands

Banging out tx on a timer is working well

ashleyjr, 2016-12-13:
Working well.

Closed 2016-12-13.

Thread 10 (2016-12-06):

UART Menu

ashleyjr, 2016-12-06:
Need to decide on a menu and features to offer.

- Change voltage
- Constant current
- Change PID tuning?

ashleyjr, 2016-12-13:
Began implementation.

Thread 9 (2016-12-06):

Switching ADCs

ashleyjr, 2016-12-06:
Need to switch ADCs and settle in between.

Current reading ADC but getting the last switch value.

Maybe put in a timer to get incoming samples?

Closed 2016-12-31.

Thread 12 (2016-12-07):

16-Bit PWM

ashleyjr, 2016-12-07:
Resolution needs to improve

ashleyjr, 2016-12-08:
Enabled 16 bit but needs testing

ashleyjr, 2016-12-14:
Still not working. Will reall help control of PID

ashleyjr, 2016-12-31:
Too slow when enabled bu would be nice to have that control

Closed 2016-12-31.
