ashleyjr/Switcher/Electronics/Simulation/Buck.asc

C2: cap; 100µF
D1: diode
D2: diode
I1: current; 100m
L1: ind; 22µH
M1: pmos
V1: voltage; PULSE(0 5 0.000001 0.000001 0.000001 0.000009 0.00001)
V2: voltage; 3.3
Named nets: 0
.tran 0 0.01 0
