ashleyjr/Switcher/Electronics/Simulation/Boost.asc

C1: cap; 1µF
C2: cap; 100µF
D1: diode
I1: current; 100m
L1: ind; 22µH
R1: res; 5K
R2: res; 10K
R3: res; 3.4K
U1: LT1072
V2: voltage; 3.3
Named nets: 0
.tran 0 0.004 0
