ashleyjr/Switcher/Embedded/Inc/SI_C8051F850_Defs.h

//------------------------------------------------------------------------------
// Copyright 2014 Silicon Laboratories, Inc.
// All rights reserved. This program and the accompanying materials
// are made available under the terms of the Silicon Laboratories End User
// License Agreement which accompanies this distribution, and is available at
// http://developer.silabs.com/legal/version/v11/Silicon_Labs_Software_License_Agreement.txt
// Original content and implementation provided by Silicon Laboratories.
//------------------------------------------------------------------------------
//Supported Devices:
//  C8051F850
//  C8051F850
//  C8051F851
//  C8051F851
//  C8051F852
//  C8051F852
//  C8051F853
//  C8051F853
//  C8051F854
//  C8051F854
//  C8051F855
//  C8051F855
//  C8051F860
//  C8051F861
//  C8051F862
//  C8051F863
//  C8051F864
//  C8051F865

#ifndef SI_C8051F850_DEFS_H
#define SI_C8051F850_DEFS_H

#include <compiler_defs.h>

//-----------------------------------------------------------------------------
// Register Definitions
//-----------------------------------------------------------------------------
SFR (ACC,      0xE0); ///< Accumulator                           
SFR (ADC0AC,   0xB3); ///< ADC0 Accumulator Configuration        
SFR (ADC0CF,   0xBC); ///< ADC0 Configuration                    
SFR (ADC0CN0,  0xE8); ///< ADC0 Control 0                        
SFR (ADC0CN1,  0xB2); ///< ADC0 Control 1                        
SFR (ADC0GTH,  0xC4); ///< ADC0 Greater-Than High Byte           
SFR (ADC0GTL,  0xC3); ///< ADC0 Greater-Than Low Byte            
SFR (ADC0H,    0xBE); ///< ADC0 Data Word High Byte              
SFR (ADC0L,    0xBD); ///< ADC0 Data Word Low Byte               
SFR (ADC0LTH,  0xC6); ///< ADC0 Less-Than High Byte              
SFR (ADC0LTL,  0xC5); ///< ADC0 Less-Than Low Byte               
SFR (ADC0MX,   0xBB); ///< ADC0 Multiplexer Selection            
SFR (ADC0PWR,  0xDF); ///< ADC0 Power Control                    
SFR (ADC0TK,   0xB9); ///< ADC0 Burst Mode Track Time            
SFR (B,        0xF0); ///< B Register                            
SFR (CKCON,    0x8E); ///< Clock Control                         
SFR (CLKSEL,   0xA9); ///< Clock Select                          
SFR (CPT0CN,   0x9B); ///< Comparator 0 Control                  
SFR (CPT0MD,   0x9D); ///< Comparator 0 Mode                     
SFR (CPT0MX,   0x9F); ///< Comparator 0 Multiplexer Selection    
SFR (CPT1CN,   0xBF); ///< Comparator 1 Control                  
SFR (CPT1MD,   0xAB); ///< Comparator 1 Mode                     
SFR (CPT1MX,   0xAA); ///< Comparator 1 Multiplexer Selection    
SFR (CRC0AUTO, 0xD2); ///< CRC0 Automatic Control                
SFR (CRC0CN,   0xCE); ///< CRC0 Control                          
SFR (CRC0CNT,  0xD3); ///< CRC0 Automatic Flash Sector Count     
SFR (CRC0DAT,  0xDE); ///< CRC0 Data Output                      
SFR (CRC0FLIP, 0xCF); ///< CRC0 Bit Flip                         
SFR (CRC0IN,   0xDD); ///< CRC0 Data Input                       
SFR (DERIVID,  0xAD); ///< Derivative Identification             
SFR (DEVICEID, 0xB5); ///< Device Identification                 
SFR (DPH,      0x83); ///< Data Pointer High                     
SFR (DPL,      0x82); ///< Data Pointer Low                      
SFR (EIE1,     0xE6); ///< Extended Interrupt Enable 1           
SFR (EIP1,     0xF3); ///< Extended Interrupt Priority 1         
SFR (FLKEY,    0xB7); ///< Flash Lock and Key                    
SFR (IE,       0xA8); ///< Interrupt Enable                      
SFR (IP,       0xB8); ///< Interrupt Priority                    
SFR (IT01CF,   0xE4); ///< INT0/INT1 Configuration               
SFR (OSCICL,   0xC7); ///< High Frequency Oscillator Calibration 
SFR (OSCLCN,   0xB1); ///< Low Frequency Oscillator Control      
SFR (P0,       0x80); ///< Port 0 Pin Latch                      
SFR (P0MASK,   0xFE); ///< Port 0 Mask                           
SFR (P0MAT,    0xFD); ///< Port 0 Match                          
SFR (P0MDIN,   0xF1); ///< Port 0 Input Mode                     
SFR (P0MDOUT,  0xA4); ///< Port 0 Output Mode                    
SFR (P0SKIP,   0xD4); ///< Port 0 Skip                           
SFR (P1,       0x90); ///< Port 1 Pin Latch                      
SFR (P1MASK,   0xEE); ///< Port 1 Mask                           
SFR (P1MAT,    0xED); ///< Port 1 Match                          
SFR (P1MDIN,   0xF2); ///< Port 1 Input Mode                     
SFR (P1MDOUT,  0xA5); ///< Port 1 Output Mode                    
SFR (P1SKIP,   0xD5); ///< Port 1 Skip                           
SFR (P2,       0xA0); ///< Port 2 Pin Latch                      
SFR (P2MDOUT,  0xA6); ///< Port 2 Output Mode                    
SFR (PCA0CENT, 0x9E); ///< PCA Center Alignment Enable           
SFR (PCA0CLR,  0x9C); ///< PCA Comparator Clear Control          
SFR (PCA0CN,   0xD8); ///< PCA Control                           
SFR (PCA0CPH0, 0xFC); ///< PCA Channel 0 Capture Module High Byte
SFR (PCA0CPH1, 0xEA); ///< PCA Channel 1 Capture Module High Byte
SFR (PCA0CPH2, 0xEC); ///< PCA Channel 2 Capture Module High Byte
SFR (PCA0CPL0, 0xFB); ///< PCA Channel 0 Capture Module Low Byte 
SFR (PCA0CPL1, 0xE9); ///< PCA Channel 1 Capture Module Low Byte 
SFR (PCA0CPL2, 0xEB); ///< PCA Channel 2 Capture Module Low Byte 
SFR (PCA0CPM0, 0xDA); ///< PCA Channel 0 Capture/Compare Mode    
SFR (PCA0CPM1, 0xDB); ///< PCA Channel 1 Capture/Compare Mode    
SFR (PCA0CPM2, 0xDC); ///< PCA Channel 2 Capture/Compare Mode    
SFR (PCA0H,    0xFA); ///< PCA Counter/Timer High Byte           
SFR (PCA0L,    0xF9); ///< PCA Counter/Timer Low Byte            
SFR (PCA0MD,   0xD9); ///< PCA Mode                              
SFR (PCA0POL,  0x96); ///< PCA Output Polarity                   
SFR (PCA0PWM,  0xF7); ///< PCA PWM Configuration                 
SFR (PCON,     0x87); ///< Power Control                         
SFR (PRTDRV,   0xF6); ///< Port Drive Strength                   
SFR (PSCTL,    0x8F); ///< Program Store Control                 
SFR (PSW,      0xD0); ///< Program Status Word                   
SFR (REF0CN,   0xD1); ///< Voltage Reference Control             
SFR (REG0CN,   0xC9); ///< Voltage Regulator Control             
SFR (REVID,    0xB6); ///< Revision Identifcation                
SFR (RSTSRC,   0xEF); ///< Reset Source                          
SFR (SBUF0,    0x99); ///< UART0 Serial Port Data Buffer         
SFR (SCON0,    0x98); ///< UART0 Serial Port Control             
SFR (SMB0ADM,  0xD6); ///< SMBus 0 Slave Address Mask            
SFR (SMB0ADR,  0xD7); ///< SMBus 0 Slave Address                 
SFR (SMB0CF,   0xC1); ///< SMBus 0 Configuration                 
SFR (SMB0CN,   0xC0); ///< SMBus 0 Control                       
SFR (SMB0DAT,  0xC2); ///< SMBus 0 Data                          
SFR (SMB0TC,   0xAC); ///< SMBus 0 Timing and Pin Control        
SFR (SP,       0x81); ///< Stack Pointer                         
SFR (SPI0CFG,  0xA1); ///< SPI0 Configuration                    
SFR (SPI0CKR,  0xA2); ///< SPI0 Clock Rate                       
SFR (SPI0CN,   0xF8); ///< SPI0 Control                          
SFR (SPI0DAT,  0xA3); ///< SPI0 Data                             
SFR (TCON,     0x88); ///< Timer 0/1 Control                     
SFR (TH0,      0x8C); ///< Timer 0 High Byte                     
SFR (TH1,      0x8D); ///< Timer 1 High Byte                     
SFR (TL0,      0x8A); ///< Timer 0 Low Byte                      
SFR (TL1,      0x8B); ///< Timer 1 Low Byte                      
SFR (TMOD,     0x89); ///< Timer 0/1 Mode                        
SFR (TMR2CN,   0xC8); ///< Timer 2 Control                       
SFR (TMR2H,    0xCD); ///< Timer 2 High Byte                     
SFR (TMR2L,    0xCC); ///< Timer 2 Low Byte                      
SFR (TMR2RLH,  0xCB); ///< Timer 2 Reload High Byte              
SFR (TMR2RLL,  0xCA); ///< Timer 2 Reload Low Byte               
SFR (TMR3CN,   0x91); ///< Timer 3 Control                       
SFR (TMR3H,    0x95); ///< Timer 3 High Byte                     
SFR (TMR3L,    0x94); ///< Timer 3 Low Byte                      
SFR (TMR3RLH,  0x93); ///< Timer 3 Reload High Byte              
SFR (TMR3RLL,  0x92); ///< Timer 3 Reload Low Byte               
SFR (VDM0CN,   0xFF); ///< Supply Monitor Control                
SFR (WDTCN,    0x97); ///< Watchdog Timer Control                
SFR (XBR0,     0xE1); ///< Port I/O Crossbar 0                   
SFR (XBR1,     0xE2); ///< Port I/O Crossbar 1                   
SFR (XBR2,     0xE3); ///< Port I/O Crossbar 2                   

//------------------------------------------------------------------------------
// 16-bit Register Definitions (may not work on all compilers)
//------------------------------------------------------------------------------
SFR16 (ADC0GT,  0xC3); ///< ADC0 Greater-Than            
SFR16 (ADC0,    0xBD); ///< ADC0 Data Word               
SFR16 (ADC0LT,  0xC5); ///< ADC0 Less-Than               
SFR16 (DP,      0x82); ///< Data Pointer                 
SFR16 (PCA0CP0, 0xFB); ///< PCA Channel 0 Capture Module 
SFR16 (PCA0CP1, 0xE9); ///< PCA Channel 1 Capture Module 
SFR16 (PCA0CP2, 0xEB); ///< PCA Channel 2 Capture Module 
SFR16 (PCA0,    0xF9); ///< PCA Counter/Timer            
SFR16 (TMR2,    0xCC); ///< Timer 2                      
SFR16 (TMR2RL,  0xCA); ///< Timer 2 Reload               
SFR16 (TMR3,    0x94); ///< Timer 3                      
SFR16 (TMR3RL,  0x92); ///< Timer 3 Reload               

//------------------------------------------------------------------------------
// Indirect Register Definitions
//------------------------------------------------------------------------------

//------------------------------------------------------------------------------
// Bit Definitions
//------------------------------------------------------------------------------

// ACC (Accumulator)
#define SFR_ACC 0xE0
SBIT (ACC_ACC0, SFR_ACC, 0); ///< Accumulator Bit 0
SBIT (ACC_ACC1, SFR_ACC, 1); ///< Accumulator Bit 1
SBIT (ACC_ACC2, SFR_ACC, 2); ///< Accumulator Bit 2
SBIT (ACC_ACC3, SFR_ACC, 3); ///< Accumulator Bit 3
SBIT (ACC_ACC4, SFR_ACC, 4); ///< Accumulator Bit 4
SBIT (ACC_ACC5, SFR_ACC, 5); ///< Accumulator Bit 5
SBIT (ACC_ACC6, SFR_ACC, 6); ///< Accumulator Bit 6
SBIT (ACC_ACC7, SFR_ACC, 7); ///< Accumulator Bit 7

// ADC0CN0 (ADC0 Control 0)
#define SFR_ADC0CN0 0xE8
SBIT (ADC0CN0_ADCM0,  SFR_ADC0CN0, 0); ///< Start of Conversion Mode Select Bit 0
SBIT (ADC0CN0_ADCM1,  SFR_ADC0CN0, 1); ///< Start of Conversion Mode Select Bit 1
SBIT (ADC0CN0_ADCM2,  SFR_ADC0CN0, 2); ///< Start of Conversion Mode Select Bit 2
SBIT (ADC0CN0_ADWINT, SFR_ADC0CN0, 3); ///< Window Compare Interrupt Flag        
SBIT (ADC0CN0_ADBUSY, SFR_ADC0CN0, 4); ///< ADC Busy                             
SBIT (ADC0CN0_ADINT,  SFR_ADC0CN0, 5); ///< Conversion Complete Interrupt Flag   
SBIT (ADC0CN0_ADBMEN, SFR_ADC0CN0, 6); ///< Burst Mode Enable                    
SBIT (ADC0CN0_ADEN,   SFR_ADC0CN0, 7); ///< ADC Enable                           

// B (B Register)
#define SFR_B 0xF0
SBIT (B_B0, SFR_B, 0); ///< B Register Bit 0
SBIT (B_B1, SFR_B, 1); ///< B Register Bit 1
SBIT (B_B2, SFR_B, 2); ///< B Register Bit 2
SBIT (B_B3, SFR_B, 3); ///< B Register Bit 3
SBIT (B_B4, SFR_B, 4); ///< B Register Bit 4
SBIT (B_B5, SFR_B, 5); ///< B Register Bit 5
SBIT (B_B6, SFR_B, 6); ///< B Register Bit 6
SBIT (B_B7, SFR_B, 7); ///< B Register Bit 7

// IE (Interrupt Enable)
#define SFR_IE 0xA8
SBIT (IE_EX0,   SFR_IE, 0); ///< External Interrupt 0 Enable
SBIT (IE_ET0,   SFR_IE, 1); ///< Timer 0 Interrupt Enable   
SBIT (IE_EX1,   SFR_IE, 2); ///< External Interrupt 1 Enable
SBIT (IE_ET1,   SFR_IE, 3); ///< Timer 1 Interrupt Enable   
SBIT (IE_ES0,   SFR_IE, 4); ///< UART0 Interrupt Enable     
SBIT (IE_ET2,   SFR_IE, 5); ///< Timer 2 Interrupt Enable   
SBIT (IE_ESPI0, SFR_IE, 6); ///< SPI0 Interrupt Enable      
SBIT (IE_EA,    SFR_IE, 7); ///< All Interrupts Enable      

// IP (Interrupt Priority)
#define SFR_IP 0xB8
SBIT (IP_PX0,   SFR_IP, 0); ///< External Interrupt 0 Priority Control                        
SBIT (IP_PT0,   SFR_IP, 1); ///< Timer 0 Interrupt Priority Control                           
SBIT (IP_PX1,   SFR_IP, 2); ///< External Interrupt 1 Priority Control                        
SBIT (IP_PT1,   SFR_IP, 3); ///< Timer 1 Interrupt Priority Control                           
SBIT (IP_PS0,   SFR_IP, 4); ///< UART0 Interrupt Priority Control                             
SBIT (IP_PT2,   SFR_IP, 5); ///< Timer 2 Interrupt Priority Control                           
SBIT (IP_PSPI0, SFR_IP, 6); ///< Serial Peripheral Interface (SPI0) Interrupt Priority Control

// P0 (Port 0 Pin Latch)
#define SFR_P0 0x80
SBIT (P0_B0, SFR_P0, 0); ///< Port 0 Bit 0 Latch
SBIT (P0_B1, SFR_P0, 1); ///< Port 0 Bit 1 Latch
SBIT (P0_B2, SFR_P0, 2); ///< Port 0 Bit 2 Latch
SBIT (P0_B3, SFR_P0, 3); ///< Port 0 Bit 3 Latch
SBIT (P0_B4, SFR_P0, 4); ///< Port 0 Bit 4 Latch
SBIT (P0_B5, SFR_P0, 5); ///< Port 0 Bit 5 Latch
SBIT (P0_B6, SFR_P0, 6); ///< Port 0 Bit 6 Latch
SBIT (P0_B7, SFR_P0, 7); ///< Port 0 Bit 7 Latch

// P1 (Port 1 Pin Latch)
#define SFR_P1 0x90
SBIT (P1_B0, SFR_P1, 0); ///< Port 1 Bit 0 Latch
SBIT (P1_B1, SFR_P1, 1); ///< Port 1 Bit 1 Latch
SBIT (P1_B2, SFR_P1, 2); ///< Port 1 Bit 2 Latch
SBIT (P1_B3, SFR_P1, 3); ///< Port 1 Bit 3 Latch
SBIT (P1_B4, SFR_P1, 4); ///< Port 1 Bit 4 Latch
SBIT (P1_B5, SFR_P1, 5); ///< Port 1 Bit 5 Latch
SBIT (P1_B6, SFR_P1, 6); ///< Port 1 Bit 6 Latch
SBIT (P1_B7, SFR_P1, 7); ///< Port 1 Bit 7 Latch

// P2 (Port 2 Pin Latch)
#define SFR_P2 0xA0
SBIT (P2_B0, SFR_P2, 0); ///< Port 2 Bit 0 Latch
SBIT (P2_B1, SFR_P2, 1); ///< Port 2 Bit 1 Latch

// PCA0CN (PCA Control)
#define SFR_PCA0CN 0xD8
SBIT (PCA0CN_CCF0, SFR_PCA0CN, 0); ///< PCA Module 0 Capture/Compare Flag
SBIT (PCA0CN_CCF1, SFR_PCA0CN, 1); ///< PCA Module 1 Capture/Compare Flag
SBIT (PCA0CN_CCF2, SFR_PCA0CN, 2); ///< PCA Module 2 Capture/Compare Flag
SBIT (PCA0CN_CR,   SFR_PCA0CN, 6); ///< PCA Counter/Timer Run Control    
SBIT (PCA0CN_CF,   SFR_PCA0CN, 7); ///< PCA Counter/Timer Overflow Flag  

// PSW (Program Status Word)
#define SFR_PSW 0xD0
SBIT (PSW_PARITY, SFR_PSW, 0); ///< Parity Flag               
SBIT (PSW_F1,     SFR_PSW, 1); ///< User Flag 1               
SBIT (PSW_OV,     SFR_PSW, 2); ///< Overflow Flag             
SBIT (PSW_RS0,    SFR_PSW, 3); ///< Register Bank Select Bit 0
SBIT (PSW_RS1,    SFR_PSW, 4); ///< Register Bank Select Bit 1
SBIT (PSW_F0,     SFR_PSW, 5); ///< User Flag 0               
SBIT (PSW_AC,     SFR_PSW, 6); ///< Auxiliary Carry Flag      
SBIT (PSW_CY,     SFR_PSW, 7); ///< Carry Flag                

// SCON0 (UART0 Serial Port Control)
#define SFR_SCON0 0x98
SBIT (SCON0_RI,    SFR_SCON0, 0); ///< Receive Interrupt Flag             
SBIT (SCON0_TI,    SFR_SCON0, 1); ///< Transmit Interrupt Flag            
SBIT (SCON0_RB8,   SFR_SCON0, 2); ///< Ninth Receive Bit                  
SBIT (SCON0_TB8,   SFR_SCON0, 3); ///< Ninth Transmission Bit             
SBIT (SCON0_REN,   SFR_SCON0, 4); ///< Receive Enable                     
SBIT (SCON0_MCE,   SFR_SCON0, 5); ///< Multiprocessor Communication Enable
SBIT (SCON0_SMODE, SFR_SCON0, 7); ///< Serial Port 0 Operation Mode       

// SMB0CN (SMBus 0 Control)
#define SFR_SMB0CN 0xC0
SBIT (SMB0CN_SI,      SFR_SMB0CN, 0); ///< SMBus Interrupt Flag            
SBIT (SMB0CN_ACK,     SFR_SMB0CN, 1); ///< SMBus Acknowledge               
SBIT (SMB0CN_ARBLOST, SFR_SMB0CN, 2); ///< SMBus Arbitration Lost Indicator
SBIT (SMB0CN_ACKRQ,   SFR_SMB0CN, 3); ///< SMBus Acknowledge Request       
SBIT (SMB0CN_STO,     SFR_SMB0CN, 4); ///< SMBus Stop Flag                 
SBIT (SMB0CN_STA,     SFR_SMB0CN, 5); ///< SMBus Start Flag                
SBIT (SMB0CN_TXMODE,  SFR_SMB0CN, 6); ///< SMBus Transmit Mode Indicator   
SBIT (SMB0CN_MASTER,  SFR_SMB0CN, 7); ///< SMBus Master/Slave Indicator    

// SPI0CN (SPI0 Control)
#define SFR_SPI0CN 0xF8
SBIT (SPI0CN_SPIEN,  SFR_SPI0CN, 0); ///< SPI0 Enable            
SBIT (SPI0CN_TXBMT,  SFR_SPI0CN, 1); ///< Transmit Buffer Empty  
SBIT (SPI0CN_NSSMD0, SFR_SPI0CN, 2); ///< Slave Select Mode Bit 0
SBIT (SPI0CN_NSSMD1, SFR_SPI0CN, 3); ///< Slave Select Mode Bit 1
SBIT (SPI0CN_RXOVRN, SFR_SPI0CN, 4); ///< Receive Overrun Flag   
SBIT (SPI0CN_MODF,   SFR_SPI0CN, 5); ///< Mode Fault Flag        
SBIT (SPI0CN_WCOL,   SFR_SPI0CN, 6); ///< Write Collision Flag   
SBIT (SPI0CN_SPIF,   SFR_SPI0CN, 7); ///< SPI0 Interrupt Flag    

// TCON (Timer 0/1 Control)
#define SFR_TCON 0x88
SBIT (TCON_IT0, SFR_TCON, 0); ///< Interrupt 0 Type Select
SBIT (TCON_IE0, SFR_TCON, 1); ///< External Interrupt 0   
SBIT (TCON_IT1, SFR_TCON, 2); ///< Interrupt 1 Type Select
SBIT (TCON_IE1, SFR_TCON, 3); ///< External Interrupt 1   
SBIT (TCON_TR0, SFR_TCON, 4); ///< Timer 0 Run Control    
SBIT (TCON_TF0, SFR_TCON, 5); ///< Timer 0 Overflow Flag  
SBIT (TCON_TR1, SFR_TCON, 6); ///< Timer 1 Run Control    
SBIT (TCON_TF1, SFR_TCON, 7); ///< Timer 1 Overflow Flag  

// TMR2CN (Timer 2 Control)
#define SFR_TMR2CN 0xC8
SBIT (TMR2CN_T2XCLK,  SFR_TMR2CN, 0); ///< Timer 2 External Clock Select    
SBIT (TMR2CN_TR2,     SFR_TMR2CN, 2); ///< Timer 2 Run Control              
SBIT (TMR2CN_T2SPLIT, SFR_TMR2CN, 3); ///< Timer 2 Split Mode Enable        
SBIT (TMR2CN_TF2CEN,  SFR_TMR2CN, 4); ///< Timer 2 Capture Enable           
SBIT (TMR2CN_TF2LEN,  SFR_TMR2CN, 5); ///< Timer 2 Low Byte Interrupt Enable
SBIT (TMR2CN_TF2L,    SFR_TMR2CN, 6); ///< Timer 2 Low Byte Overflow Flag   
SBIT (TMR2CN_TF2H,    SFR_TMR2CN, 7); ///< Timer 2 High Byte Overflow Flag  

//------------------------------------------------------------------------------
// Interrupt Definitions
//------------------------------------------------------------------------------
#define INT0_IRQn    0  ///< External Interrupt 0  
#define TIMER0_IRQn  1  ///< Timer 0 Overflow      
#define INT1_IRQn    2  ///< External Interrupt 1  
#define TIMER1_IRQn  3  ///< Timer 1 Overflow      
#define UART0_IRQn   4  ///< UART0                 
#define TIMER2_IRQn  5  ///< Timer 2 Overflow      
#define SPI0_IRQn    6  ///< SPI0                  
#define SMBUS0_IRQn  7  ///< SMBus 0               
#define PMATCH_IRQn  8  ///< Port Match            
#define ADC0WC_IRQn  9  ///< ADC0 Window Compare   
#define ADC0EOC_IRQn 10 ///< ADC0 End of Conversion
#define PCA0_IRQn    11 ///< PCA0                  
#define CMP0_IRQn    12 ///< Comparator 0          
#define CMP1_IRQn    13 ///< Comparator 1          
#define TIMER3_IRQn  14 ///< Timer 3 Overflow      

//-----------------------------------------------------------------------------
// SDCC PDATA External Memory Paging Support
//-----------------------------------------------------------------------------

#if defined SDCC

SFR(_XPAGE, 0xAA); // Point to the EMI0CN register

#endif

#endif // SI_C8051F850_DEFS_H
//-eof--------------------------------------------------------------------------
