ashleyjr/Switcher/Documentation/Switcher.asm

C:0x0000    020BAA   LJMP     C:0BAA
C:0x0003    00       NOP      
C:0x0004    00       NOP      
C:0x0005    00       NOP      
C:0x0006    00       NOP      
C:0x0007    00       NOP      
C:0x0008    00       NOP      
C:0x0009    00       NOP      
C:0x000A    00       NOP      
C:0x000B    00       NOP      
C:0x000C    00       NOP      
C:0x000D    00       NOP      
C:0x000E    00       NOP      
C:0x000F    00       NOP      
C:0x0010    00       NOP      
C:0x0011    00       NOP      
C:0x0012    00       NOP      
C:0x0013    00       NOP      
C:0x0014    00       NOP      
C:0x0015    00       NOP      
C:0x0016    00       NOP      
C:0x0017    00       NOP      
C:0x0018    00       NOP      
C:0x0019    00       NOP      
C:0x001A    00       NOP      
C:0x001B    020BB6   LJMP     TIMER1_ISR(C:0BB6)
C:0x001E    00       NOP      
C:0x001F    00       NOP      
C:0x0020    00       NOP      
C:0x0021    00       NOP      
C:0x0022    00       NOP      
C:0x0023    00       NOP      
C:0x0024    00       NOP      
C:0x0025    00       NOP      
C:0x0026    00       NOP      
C:0x0027    00       NOP      
C:0x0028    00       NOP      
C:0x0029    00       NOP      
C:0x002A    00       NOP      
C:0x002B    02094C   LJMP     TIMER2_ISR(C:094C)
C:0x002E    00       NOP      
C:0x002F    00       NOP      
C:0x0030    00       NOP      
C:0x0031    00       NOP      
C:0x0032    00       NOP      
C:0x0033    00       NOP      
C:0x0034    00       NOP      
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
C:0x07DC    00       NOP      
C:0x07DD    00       NOP      
C:0x07DE    00       NOP      
C:0x07DF    00       NOP      
C:0x07E0    00       NOP      
C:0x07E1    00       NOP      
C:0x07E2    00       NOP      
C:0x07E3    00       NOP      
C:0x07E4    00       NOP      
C:0x07E5    00       NOP      
C:0x07E6    00       NOP      
C:0x07E7    00       NOP      
C:0x07E8    00       NOP      
C:0x07E9    00       NOP      
C:0x07EA    00       NOP      
C:0x07EB    00       NOP      
C:0x07EC    00       NOP      
C:0x07ED    00       NOP      
C:0x07EE    00       NOP      
C:0x07EF    00       NOP      
C:0x07F0    00       NOP      
C:0x07F1    00       NOP      
C:0x07F2    00       NOP      
C:0x07F3    00       NOP      
C:0x07F4    00       NOP      
C:0x07F5    00       NOP      
C:0x07F6    00       NOP      
C:0x07F7    00       NOP      
C:0x07F8    00       NOP      
C:0x07F9    00       NOP      
C:0x07FA    00       NOP      
C:0x07FB    00       NOP      
C:0x07FC    00       NOP      
C:0x07FD    00       NOP      
C:0x07FE    00       NOP      
C:0x07FF    00       NOP      
    71: void main (void){ 
    72:         // Start of peripheral setup 
    73:         U8 TCON_save; 
    74:         // Watchdog  
    75:                 WDTCN = 0xDE;                 // First key 
C:0x0800    7597DE   MOV      WDTCN(0x97),#0xDE
    76:                 WDTCN = 0xAD;                 // Second key - Watchdog now disabled 
    77:         // Clock 
C:0x0803    7597AD   MOV      WDTCN(0x97),#0xAD
    78:                 CLKSEL =  
    79:                         CLKSEL_CLKSL__HFOSC                 |   // Use 24.5MHz interal clock 
    80:                         CLKSEL_CLKDIV__SYSCLK_DIV_1;            // Do not divide 
    81:         // Port 0 
C:0x0806    E4       CLR      A
C:0x0807    F5A9     MOV      CLKSEL(0xA9),A
    82:                 P0MDOUT =  
    83:                         P0MDOUT_B0__PUSH_PULL         |         // PWM1 output 
    84:                         P0MDOUT_B1__PUSH_PULL         |         // PWM2 output 
    85:                         P0MDOUT_B2__OPEN_DRAIN        |  
    86:                         P0MDOUT_B3__OPEN_DRAIN     |  
    87:                         P0MDOUT_B4__PUSH_PULL         |         // UART TX 
    88:                         P0MDOUT_B5__OPEN_DRAIN        |         // UART RX 
    89:                         P0MDOUT_B6__OPEN_DRAIN     |  
    90:                         P0MDOUT_B7__OPEN_DRAIN; 
    91:         // Port 1 
C:0x0809    75A413   MOV      P0MDOUT(0xA4),#0x13
    92:                 P1MDOUT =  
    93:                         P1MDOUT_B0__OPEN_DRAIN     |  
    94:                         P1MDOUT_B1__OPEN_DRAIN     |  
    95:                         P1MDOUT_B2__OPEN_DRAIN        |  
    96:                         P1MDOUT_B3__PUSH_PULL         |         // TEST2 
    97:                         P1MDOUT_B4__PUSH_PULL         |         // TEST1 
    98:                         P1MDOUT_B5__OPEN_DRAIN        |  
    99:                         P1MDOUT_B6__OPEN_DRAIN     |  
   100:                         P1MDOUT_B7__OPEN_DRAIN; 
C:0x080C    75A518   MOV      P1MDOUT(0xA5),#0x18
   101:                 P1MDIN =  
   102:                         P1MDIN_B0__ANALOG                               |     // ADC1 
   103:                         P1MDIN_B1__ANALOG                               |     // ADC2 
   104:                         P1MDIN_B2__ANALOG                                   |      // ADC3 
   105:                         P1MDIN_B3__DIGITAL                          |  
   106:                         P1MDIN_B4__DIGITAL                          |  
   107:                         P1MDIN_B5__DIGITAL                              |  
   108:                         P1MDIN_B6__DIGITAL                          |  
   109:                         P1MDIN_B7__DIGITAL; 
   110:         // Port crossbar 
C:0x080F    75F2F8   MOV      P1MDIN(0xF2),#0xF8
   111:                 XBR0 =  
   112:                         XBR0_URT0E__ENABLED                 |   // Route out UART 
   113:                         XBR0_SPI0E__DISABLED             |  
   114:                         XBR0_SMB0E__DISABLED                |  
   115:                         XBR0_CP0E__DISABLED                 |  
   116:                         XBR0_CP0AE__DISABLED             |  
   117:                         XBR0_CP1E__DISABLED                         |  
   118:                         XBR0_CP1AE__DISABLED             | 
   119:                         XBR0_SYSCKE__DISABLED; 
C:0x0812    75E101   MOV      XBR0(0xE1),#0x01
   120:                 XBR1 =  
   121:                         XBR1_PCA0ME__CEX0_CEX1     |        // Route out PCA0 and PCA1 
   122:                         XBR1_ECIE__DISABLED                 |  
   123:                         XBR1_T0E__DISABLED                              |  
   124:                         XBR1_T1E__DISABLED                          | 
   125:                         XBR1_T2E__DISABLED; 
C:0x0815    75E202   MOV      XBR1(0xE2),#0x02
   126:                 XBR2 =  
   127:                         XBR2_WEAKPUD__PULL_UPS_ENABLED   |        // Weak pull ups 
   128:                         XBR2_XBARE__ENABLED;                    // Enable cross bar 
   129:         // ADC 
   130:                 //ADC0MX =                                              // Mux set in application 
   131:                 //      ADC0MX_ADC0MX__ADC0P10; 
C:0x0818    75E340   MOV      XBR2(0xE3),#0x40
   132:                 ADC0CF =  
   133:                         (1 << ADC0CF_ADSC__SHIFT)                   |  
   134:                         ADC0CF_AD8BE__NORMAL             |  // ADC set to 10 bit 
   135:                         ADC0CF_ADGN__GAIN_1                 |   // ADC gain set to 1 
   136:                         ADC0CF_ADTM__TRACK_NORMAL;                        // Immediate covert 
C:0x081B    75BC09   MOV      ADC0CF(0xBC),#0x09
   137:                 ADC0CN0 &= 
   138:                         ~ADC0CN0_ADCM__FMASK; 
C:0x081E    53E8F8   ANL      ADC0CN0(0xE8),#0xF8
   139:                 ADC0CN0 |=  
   140:                         ADC0CN0_ADEN__ENABLED            | 
   141:                         ADC0CN0_ADCM__ADBUSY; 
   142:         // Timer 0 
C:0x0821    43E880   ORL      ADC0CN0(0xE8),#0x80
   143:                 TCON_save = TCON; 
C:0x0824    AF88     MOV      R7,TCON(0x88)
   144:                 TCON &=  
   145:                         TCON_TR0__BMASK                                         &         
   146:                         TCON_TR1__BMASK; 
C:0x0826    F588     MOV      TCON(0x88),A
   147:                 TH1 = (150 << TH1_TH1__SHIFT); 
C:0x0828    758D96   MOV      TH1(0x8D),#0x96
   148:                 TL1 = (150 << TL1_TL1__SHIFT); 
C:0x082B    758B96   MOV      TL1(0x8B),#0x96
   149:                 TCON =  
   150:                         TCON_save; 
   151:         // Timer setup 
C:0x082E    8F88     MOV      TCON(0x88),R7
   152:                 CKCON =  
   153:                         CKCON_SCA__SYSCLK_DIV_12                      |  
   154:                         CKCON_T0M__PRESCALE                 |  
   155:                         CKCON_T3MH__EXTERNAL_CLOCK                |  
   156:                         CKCON_T3ML__EXTERNAL_CLOCK                  |  
   157:                         CKCON_T1M__SYSCLK; 
C:0x0830    758E08   MOV      CKCON(0x8E),#0x08
   158:                 TMOD =  
   159:                         TMOD_T0M__MODE0                                         |  
   160:                         TMOD_CT0__TIMER                                         |  
   161:                         TMOD_GATE0__DISABLED                |  
   162:                         TMOD_T1M__MODE2                                         |  
   163:                         TMOD_CT1__TIMER                                         |  
   164:                         TMOD_GATE1__DISABLED; 
C:0x0833    758920   MOV      TMOD(0x89),#0x20
   165:                 TCON |=  
   166:                         TCON_TR1__RUN ; 
   167:         // UART 
C:0x0836    438840   ORL      TCON(0x88),#0x40
   168:                 SCON0 |=  
   169:                         SCON0_REN__RECEIVE_ENABLED; 
   170:         // VREF 
C:0x0839    439810   ORL      SCON0(0x98),#0x10
   171:                 REF0CN =  
   172:                         REF0CN_REFSL__VDD_PIN         |  
   173:                         REF0CN_IREFLVL__1P65             |  
   174:                         REF0CN_GNDSL__GND_PIN            |  
   175:                         REF0CN_TEMPE__TEMP_DISABLED; 
   176:         // RSTSRC 
C:0x083C    75D108   MOV      REF0CN(0xD1),#0x08
   177:                 RSTSRC =  
   178:                         RSTSRC_C0RSEF__NOT_SET     |  
   179:                         RSTSRC_MCDRSF__SET                          |  
   180:                         RSTSRC_PORSF__SET                                   |  
   181:                         RSTSRC_SWRSF__NOT_SET; 
   182:         // Interrupt 
C:0x083F    75EF06   MOV      RSTSRC(0xEF),#0x06
   183:                 IE =  
   184:                         IE_EA__ENABLED       |  
   185:                         IE_EX0__DISABLED                                    |  
   186:                         IE_EX1__DISABLED                                    |  
   187:                         IE_ESPI0__DISABLED                              |  
   188:                         IE_ET0__DISABLED                                    |  
   189:                         IE_ET1__ENABLED      |        // Timer 1 enabled 
   190:                         IE_ET2__ENABLED                                         |       // Timer 2 enabled 
   191:                         IE_ES0__ENABLED; 
C:0x0842    75A8B8   MOV      IE(0xA8),#IP(0xB8)
   192:                 IP =  
   193:                         IP_PX0__LOW                         |  
   194:                         IP_PX1__LOW                         |  
   195:                         IP_PSPI0__LOW             |  
   196:                         IP_PT0__LOW                         |  
   197:                         IP_PT1__LOW                                   | 
   198:                         IP_PT2__HIGH                   |  // Timer 2 highest priority 
   199:                         IP_PS0__LOW; 
   200:         // PCA 
C:0x0845    75B820   MOV      IP(0xB8),#0x20
   201:                 PCA0CN_CR = 
   202:                         PCA0CN_CR__STOP; 
C:0x0848    C2DE     CLR      PCA0CN_CR(0xD8.6)
   203:                 PCA0CPM0 =  
   204:                         PCA0CPM0_CAPN__DISABLED                         |  
   205:                         PCA0CPM0_ECCF__ENABLED     |  
   206:                         PCA0CPM0_MAT__ENABLED            |  
   207:                         PCA0CPM0_CAPP__DISABLED                         |  
   208:                         PCA0CPM0_ECOM__ENABLED        |  
   209:                         PCA0CPM0_PWM__ENABLED         |  
   210:                         PCA0CPM0_TOG__DISABLED; 
C:0x084A    75DA4B   MOV      PCA0CPM0(0xDA),#0x4B
   211:                 PCA0CPM1 =  
   212:                         PCA0CPM1_CAPN__DISABLED                         |  
   213:                         PCA0CPM1_ECCF__ENABLED     |                  
   214:                         PCA0CPM1_MAT__ENABLED            |  
   215:                         PCA0CPM1_CAPP__DISABLED                         |  
   216:                         PCA0CPM1_ECOM__ENABLED        |  
   217:                         PCA0CPM1_PWM__ENABLED         |  
   218:                         PCA0CPM1_TOG__DISABLED; 
C:0x084D    75DB4B   MOV      PCA0CPM1(0xDB),#0x4B
   219:                 PCA0MD =  
   220:                         PCA0MD_CIDL__NORMAL                 |  
   221:                         PCA0MD_ECF__OVF_INT_DISABLED       |  
   222:                         PCA0MD_CPS__SYSCLK;           
C:0x0850    75D908   MOV      PCA0MD(0xD9),#0x08
   223:                 PCA0CN |=  
   224:                         PCA0CN_CR__RUN; 
   225:         // Timer 2 
C:0x0853    43D840   ORL      PCA0CN(0xD8),#0x40
   226:                 TMR2CN |= TMR2CN_TR2__RUN; 
   227:         // End of peripheral setup 
   228:          
C:0x0856    43C804   ORL      TMR2CN(0xC8),#0x04
   229:         enabled         = false; 
C:0x0859    C202     CLR      enabled(0x20.2)
   230:         integral        = 0; 
C:0x085B    F52E     MOV      integral(0x2E),A
C:0x085D    F52F     MOV      0x2F,A
   231:         target_mV       = DEFAULT_OUT_MV; 
C:0x085F    752513   MOV      target_mV(0x25),#0x13
C:0x0862    752688   MOV      0x26,#TCON(0x88)
   232:         high_mV  = DEFAULT_HIGH_MV; 
C:0x0865    752717   MOV      high_mV(0x27),#0x17
C:0x0868    752870   MOV      0x28,#0x70
   233:         low_mV    = DEFAULT_LOW_MV; 
   234:          
C:0x086B    75370F   MOV      low_mV(0x37),#0x0F
C:0x086E    7538A0   MOV      0x38,#0xA0
   235:         SCON0_TI        = 1;  
C:0x0871    D299     SETB     SCON0_TI(0x98.1)
   236:         SCON0_RI        = 0; 
   237:          
C:0x0873    C298     CLR      SCON0_RI(0x98.0)
   238:         while (1){ 
   239:                 if(SCON0_RI){ 
C:0x0875    3098FD   JNB      SCON0_RI(0x98.0),C:0875
   240:                         SCON0_RI = 0; 
C:0x0878    C298     CLR      SCON0_RI(0x98.0)
   241:                         uart_in[4] = uart_in[3];                                                                                // Small buffer, less code not to use loop 
C:0x087A    853536   MOV      0x36,0x35
   242:                         uart_in[3] = uart_in[2]; 
C:0x087D    853435   MOV      0x35,0x34
   243:                         uart_in[2] = uart_in[1]; 
C:0x0880    853334   MOV      0x34,0x33
   244:                         uart_in[1] = uart_in[0]; 
C:0x0883    853233   MOV      0x33,uart_in(0x32)
   245:                         uart_in[0] = SBUF0; 
   246:                          
C:0x0886    859932   MOV      uart_in(0x32),SBUF0(0x99)
   247:                         uartLoadOut(uart_in[0]); 
   248:                          
C:0x0889    AF32     MOV      R7,uart_in(0x32)
C:0x088B    120B9C   LCALL    uartLoadOut(C:0B9C)
   249:                         switch(uart_in[0]){ 
C:0x088E    E532     MOV      A,uart_in(0x32)
C:0x0890    120AA6   LCALL    C?CCASE(C:0AA6)
C:0x0893    08       INC      R0
C:0x0894    B56108   CJNE     A,0x61,C:089F
C:0x0897    BD6308   CJNE     R5,#0x63,C:08A2
C:0x089A    C564     XCH      A,0x64
C:0x089C    08       INC      R0
C:0x089D    CD       XCH      A,R5
C:0x089E    67       XRL      A,@R1
C:0x089F    08       INC      R0
C:0x08A0    DA6D     DJNZ     R2,C:090F
C:0x08A2    08       INC      R0
C:0x08A3    E2       MOVX     A,@R0
C:0x08A4    6E       XRL      A,R6
C:0x08A5    08       INC      R0
C:0x08A6    D6       XCHD     A,@R0
C:0x08A7    73       JMP      @A+DPTR
C:0x08A8    08       INC      R0
C:0x08A9    EA       MOV      A,R2
C:0x08AA    7808     MOV      R0,#0x08
C:0x08AC    F2       MOVX     @R0,A
C:0x08AD    7908     MOV      R1,#0x08
C:0x08AF    FA       MOV      R2,A
C:0x08B0    7A00     MOV      R2,#0x00
C:0x08B2    00       NOP      
C:0x08B3    09       INC      R1
C:0x08B4    06       INC      @R0
   250:                                 case 'a':       uartNumbers(target_mV,true); 
C:0x08B5    D200     SETB     0x20.0
C:0x08B7    AF26     MOV      R7,0x26
C:0x08B9    AE25     MOV      R6,target_mV(0x25)
   251:                                                         break; 
C:0x08BB    8043     SJMP     C:0900
   252:                                 case 'c':       uartNumbers(current,true); 
C:0x08BD    D200     SETB     0x20.0
C:0x08BF    AF22     MOV      R7,0x22
C:0x08C1    AE21     MOV      R6,current(0x21)
   253:                                                         break; 
C:0x08C3    803B     SJMP     C:0900
   254:                                 case 'd':       uartNumbers(duty,true); 
C:0x08C5    AF29     MOV      R7,duty(0x29)
C:0x08C7    7E00     MOV      R6,#0x00
C:0x08C9    D200     SETB     0x20.0
   255:                                                         break; 
C:0x08CB    8033     SJMP     C:0900
   256:                                 case 'g':       enabled       = true; 
C:0x08CD    D202     SETB     enabled(0x20.2)
   257:                                                         integral        = 0; 
C:0x08CF    E4       CLR      A
C:0x08D0    F52E     MOV      integral(0x2E),A
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
C:0x0AEE    E5F0     MOV      A,0xF0
C:0x0AF0    28       ADD      A,R0
C:0x0AF1    FE       MOV      R6,A
C:0x0AF2    E4       CLR      A
C:0x0AF3    3D       ADDC     A,R5
C:0x0AF4    FD       MOV      R5,A
C:0x0AF5    E4       CLR      A
C:0x0AF6    3C       ADDC     A,R4
C:0x0AF7    FC       MOV      R4,A
C:0x0AF8    22       RET      
   296: U16 uartNumbers(U16 toSend, bool transmit){               // Tx/Rx up to 4 length numbers over UART 
   297:         U16 out = toSend; 
C:0x0AF9    8E08     MOV      0x08,R6
C:0x0AFB    8F09     MOV      0x09,R7
   298:         U16 num = 0; 
C:0x0AFD    E4       CLR      A
C:0x0AFE    FB       MOV      R3,A
C:0x0AFF    FA       MOV      R2,A
   299:         U16 scale = 10000; 
   300:         U8 test; 
C:0x0B00    902710   MOV      DPTR,#0x2710
   301:         U8 i = 4; 
C:0x0B03    750B04   MOV      0x0B,#0x04
   302:         bool bad = false; 
C:0x0B06    C201     CLR      0x20.1
   303:         while(i){                                                                      // On zero done 
C:0x0B08    E50B     MOV      A,0x0B
C:0x0B0A    6059     JZ       C:0B65
   304:                 scale /= 10;                                // Shift 
C:0x0B0C    7C00     MOV      R4,#0x00
C:0x0B0E    7D0A     MOV      R5,#0x0A
C:0x0B10    AF82     MOV      R7,0x82
C:0x0B12    AE83     MOV      R6,0x83
C:0x0B14    120A3E   LCALL    C?UIDIV(C:0A3E)
C:0x0B17    8E83     MOV      0x83,R6
C:0x0B19    8F82     MOV      0x82,R7
   305:                 i--;                                        // Move through UART array 
C:0x0B1B    150B     DEC      0x0B
   306:                 test = uart_in[i] - 48;      // ascii to num 
C:0x0B1D    7432     MOV      A,#uart_in(0x32)
C:0x0B1F    250B     ADD      A,0x0B
C:0x0B21    F8       MOV      R0,A
C:0x0B22    E6       MOV      A,@R0
C:0x0B23    24D0     ADD      A,#0xD0
C:0x0B25    F50A     MOV      0x0A,A
   307:                 if(test > 10){                // check is 0 to 9, unsigned 
C:0x0B27    D3       SETB     C
C:0x0B28    940A     SUBB     A,#0x0A
C:0x0B2A    4002     JC       C:0B2E
   308:                         bad = true; 
C:0x0B2C    D201     SETB     0x20.1
   309:                 } 
   310:                 num += test*scale;                                          // shift in to position 
C:0x0B2E    AF0A     MOV      R7,0x0A
C:0x0B30    7E00     MOV      R6,#0x00
C:0x0B32    AD82     MOV      R5,0x82
C:0x0B34    AC83     MOV      R4,0x83
C:0x0B36    120A2C   LCALL    C?IMUL(C:0A2C)
C:0x0B39    EF       MOV      A,R7
C:0x0B3A    2B       ADD      A,R3
C:0x0B3B    FB       MOV      R3,A
C:0x0B3C    EE       MOV      A,R6
C:0x0B3D    3A       ADDC     A,R2
C:0x0B3E    FA       MOV      R2,A
   311:                 if(transmit){                        // Put if statement at back of loop to save on jumps  
C:0x0B3F    3000C6   JNB      0x20.0,C:0B08
   312:                         num = out / scale;                                    // 10 powers 
C:0x0B42    AE08     MOV      R6,0x08
C:0x0B44    AF09     MOV      R7,0x09
C:0x0B46    120A3E   LCALL    C?UIDIV(C:0A3E)
C:0x0B49    AA06     MOV      R2,0x06
C:0x0B4B    AB07     MOV      R3,0x07
   313:                         uartLoadOut(num + 48);          // Number to ascii 
C:0x0B4D    EF       MOV      A,R7
C:0x0B4E    2430     ADD      A,#adc3(0x30)
C:0x0B50    FF       MOV      R7,A
C:0x0B51    120B9C   LCALL    uartLoadOut(C:0B9C)
   314:                         out %= scale;                     // Remainder for next time 
C:0x0B54    AE08     MOV      R6,0x08
C:0x0B56    AF09     MOV      R7,0x09
C:0x0B58    AD82     MOV      R5,0x82
C:0x0B5A    AC83     MOV      R4,0x83
C:0x0B5C    120A3E   LCALL    C?UIDIV(C:0A3E)
C:0x0B5F    8C08     MOV      0x08,R4
C:0x0B61    8D09     MOV      0x09,R5
   315:                 } 
   316:         } 
C:0x0B63    80A3     SJMP     C:0B08
   317:         uartLoadOut('\n'); 
C:0x0B65    7F0A     MOV      R7,#0x0A
C:0x0B67    120B9C   LCALL    uartLoadOut(C:0B9C)
   318:         uartLoadOut('\r'); 
C:0x0B6A    7F0D     MOV      R7,#0x0D
C:0x0B6C    120B9C   LCALL    uartLoadOut(C:0B9C)
   319:         if(bad){ 
C:0x0B6F    300104   JNB      0x20.1,C:0B76
   320:                 num = DEFAULT_OUT_MV;                  // Not all valid numbers so set output as default 
C:0x0B72    7A13     MOV      R2,#0x13
C:0x0B74    7B88     MOV      R3,#TCON(0x88)
   321:         } 
   322:         return num; 
C:0x0B76    AE02     MOV      R6,0x02
C:0x0B78    AF03     MOV      R7,0x03
   323: } 
   324:  
C:0x0B7A    22       RET      
   325: U16 readAdc(U8 sel){                                // Read the available ADCs 
   326:         U8 i; 
   327:         ADC0MX = sel; 
C:0x0B7B    8FBB     MOV      ADC0MX(0xBB),R7
   328:         for(i=0;i<2;i++){ 
C:0x0B7D    E4       CLR      A
C:0x0B7E    FF       MOV      R7,A
   329:                 ADC0CN0 |= ADC0CN0_ADBUSY__SET; 
C:0x0B7F    43E810   ORL      ADC0CN0(0xE8),#0x10
   330:                 while(ADC0CN0 & ADC0CN0_ADBUSY__SET);      // Wait for sample to complete 
C:0x0B82    E5E8     MOV      A,ADC0CN0(0xE8)
C:0x0B84    20E4FB   JB       0xE0.4,C:0B82
   331:         } 
C:0x0B87    0F       INC      R7
C:0x0B88    BF02F4   CJNE     R7,#0x02,C:0B7F
   332:         return (((U32)ADC0)*SCALE_MUL) >> 10;         // Scale to mV 
C:0x0B8B    AFBD     MOV      R7,ADC0(0xBD)
C:0x0B8D    AEBE     MOV      R6,0xBE
C:0x0B8F    7C17     MOV      R4,#0x17
C:0x0B91    7DB4     MOV      R5,#0xB4
C:0x0B93    120ACC   LCALL    C?LIMUL(C:0ACC)
C:0x0B96    780A     MOV      R0,#0x0A
C:0x0B98    120A93   LCALL    C?ULSHR(C:0A93)
   333: } 
   334:  
   335: //----------------------------------------------------------------------------- 
   336: // Interrupt Routines 
   337: //----------------------------------------------------------------------------- 
   338:  
C:0x0B9B    22       RET      
   290: void uartLoadOut(U8 tx){                                                        // Handle buffering out Tx UART 
   291:         uart_out[head] = tx;                            // Buffer outgoing 
C:0x0B9C    AE23     MOV      R6,head(0x23)
C:0x0B9E    7439     MOV      A,#uart_out(0x39)
C:0x0BA0    2E       ADD      A,R6
C:0x0BA1    F8       MOV      R0,A
C:0x0BA2    A607     MOV      @R0,0x07
   292:         head++;       
C:0x0BA4    0523     INC      head(0x23)
   293:         head %= UART_SIZE_OUT;              // Wrap around 
C:0x0BA6    532307   ANL      head(0x23),#0x07
   294: } 
C:0x0BA9    22       RET      
C:0x0BAA    787F     MOV      R0,#0x7F
C:0x0BAC    E4       CLR      A
C:0x0BAD    F6       MOV      @R0,A
C:0x0BAE    D8FD     DJNZ     R0,C:0BAD
C:0x0BB0    758140   MOV      0x81,#0x40
C:0x0BB3    020800   LJMP     main(C:0800)
   339: INTERRUPT (TIMER1_ISR, TIMER1_IRQn){}            // Needed for UART timing 
C:0x0BB6    32       RETI     
