ashleyjr/Switcher/(commit log)

2016-11-28 started keil project and brought in example files
    [InitDevice.obj, main.obj]
2016-11-28 remove temp files
    [InitDevice.obj, main.obj]
2016-11-29 moved pid file
2016-11-29 switcher Pid to 16 bit
2016-11-29 added i and d to pid
2016-11-30 simulation with off the shelf switcher
2016-11-30 open loop buck
2016-12-01 uart working on dev board
2016-12-01 using putchar not printf to serial
2016-12-01 reading ADC and sending over UART
2016-12-01 keep track of tools
2016-12-02 pwm controlled driectly by adc with feedback on uart
2016-12-02 8-bit pwm working
2016-12-02 tidy up interrupts
2016-12-03 redo uart functions
2016-12-03 two pwm outputs in phase
2016-12-03 cutom number printing
2016-12-03 put uart num send in to loop
2016-12-03 tidy up pwm print in main
2016-12-03 polling ADC without clock
2016-12-03 calling adc function
2016-12-03 timer 2 interrupt fast running
2016-12-03 no need to update pwm from interrupt
2016-12-03 disable the PCA0 interrupt
2016-12-03 testing pid with no hardware
2016-12-04 buffer uart output
2016-12-04 using timer for pid to unload the UART buffer
2016-12-04 added schematics for prototype to build
    [Switcher.sch]
2016-12-04 add headers for dev board
2016-12-04 redo designators
    [Switcher.sch]
2016-12-04 placed order for hardware
    [2016_12_04_Farnell.csv, Switcher.sch]
2016-12-04 adjust mapping to micro
    [Switcher.sch]
2016-12-04 muxing the ADC
2016-12-04 ADC defs
2016-12-04 running uart send from another timer
2016-12-05 using a soft timer to space between pid calls
2016-12-06 sample different ADCs
2016-12-07 enabled pwm output
2016-12-07 test for PWM
2016-12-08 redo gpio pin mux and remove skips
    [main.c]
2016-12-08 enabled 16 bit pwm
2016-12-12 UART ISR back in
2016-12-15 add scaling to adc reading
2016-12-15 changed pwm to use bool to select
2016-12-15 remove uart call function
2016-12-19 added uart table menu
2016-12-19 starting gui to control the switcher
2016-12-20 tune timer 2 so no soft timing
2016-12-20 got rid of timer 1
2016-12-20 interrupt required for uart
2016-12-20 fixed point for building string
    [main.c]
2016-12-21 buck boost working
2016-12-21 watch for low switching a 16 bit clock
2016-12-24 tidy up pid
2016-12-30 back to 8 bit pwm
2016-12-30 removed p from pid as don't need a fast response
2016-12-30 Revert "removed p from pid as don't need a fast response"
    This reverts commit bff48d01035141e80e9b750fc564ad73fd6d21d7.
    [main.c]
2016-12-30 buck boost
2016-12-30 moved pid in to timer
2016-12-30 sending output voltage
2016-12-30 less than 1KB with number swapping routine
    [main.c]
2016-12-30 5 bytes saved by not using if to reset buffer
    [main.c]
2016-12-30 opt uart nums
2016-12-31 no need to handle uart in isr
2016-12-31 opt interrupt
2016-12-31 improve the adc reading operation
2017-01-02 more adc read features
2017-01-02 current plot feature
2017-01-02 can output duty of pwm
